FredM67/PVRouter-KiCad/Readme.md

Français | **[English](Readme.en.md)**

# PVRouter-KiCad

Fichiers de conception KiCad pour le **Mk2 PV Router** — un système open-source de routage solaire photovoltaïque universel (monophasé, triphasé avec ou sans neutre, biphasé).

Inspiré par [www.mk2pvrouter.co.uk](https://www.mk2pvrouter.co.uk), ce projet fournit les schémas et circuits imprimés nécessaires pour construire un routeur PV capable de dévier l’excédent de production solaire vers des charges résistives (chauffe-eau, radiateurs, etc.).

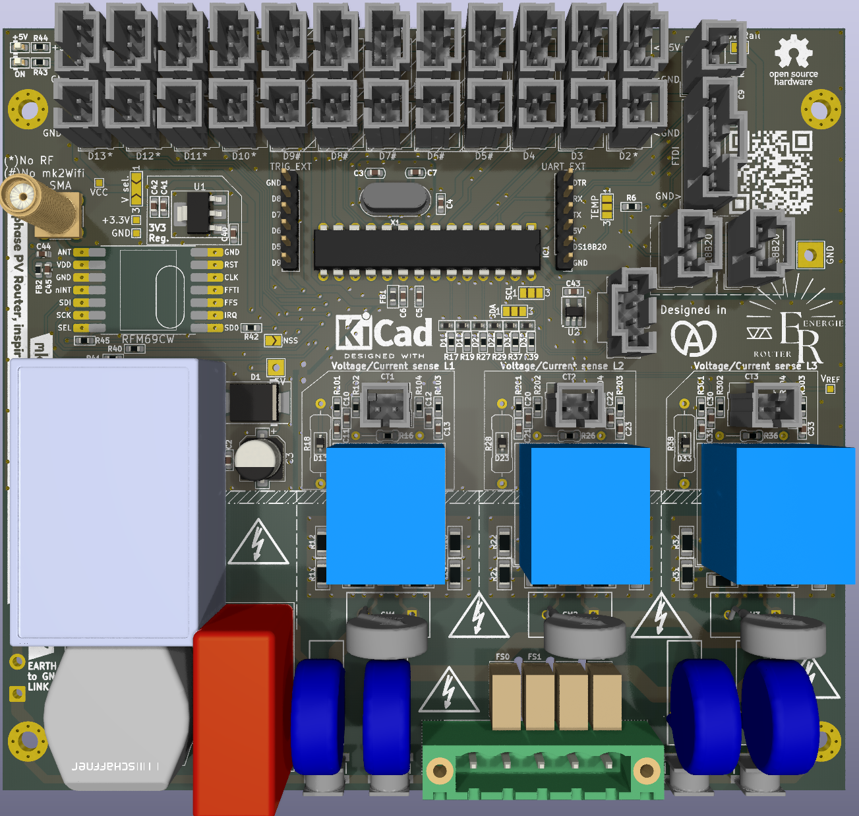
[picture p1: mainboard/assets/3phaseDiverter-front.png]
Carte principale


## Structure du dépôt

| Répertoire | Description | État |
|---|---|---|
| [`mainboard/`](mainboard/) | Carte principale universelle (3phaseDiverter) — rév. 6.0 | Conception active |
| [`output_stage/`](output_stage/) | Étage de puissance de sortie (carte séparée) | Conception active |
| [`expansion_boards/mk2Wifi-C3/`](expansion_boards/mk2Wifi-C3/) | Module d’extension WiFi/BLE (ESP32-C3) | Conception active |
| [`expansion_boards/mk2Wifi-C6/`](expansion_boards/mk2Wifi-C6/) | Module d’extension WiFi 6/BLE/Zigbee/Thread (ESP32-C6) | Conception active |
| [`1-phase/`](1-phase/) | Variante monophasée (schéma uniquement, pas de PCB) | Obsolète — encore en vente |
| [`3-phase/`](3-phase/) | Variante triphasée (ancienne version) | Obsolète — encore en vente |
| [`KiCad/`](KiCad/) | Bibliothèques partagées (symboles, empreintes, modèles 3D) | — |

## Carte principale

La carte principale est le cœur du projet. Universelle, elle prend en charge les configurations monophasée, triphasée (avec ou sans neutre) et biphasée (split-phase). Selon la configuration, jusqu’à 3 transformateurs de courant (CT) sont nécessaires. Elle intègre :

- Microcontrôleur ATmega328P
- Jusqu’à 3 capteurs de courant (transformateurs de courant)
- Jusqu’à 3 capteurs de tension (ZMPT101B)
- Module radio RFM69 (433 MHz)
- Alimentation intégrée à partir du secteur
- Protection contre les surtensions (GDT + fusibles)
- Connecteurs d’extension (TRIG_EXT, UART_EXT)

La carte est conçue pour être montée dans un boîtier Schneider Electric Thalassa.

## Modules d’extension

- **[mk2Wifi-C3](expansion_boards/mk2Wifi-C3/)** — Module WiFi/BLE basé sur l'ESP32-C3-MINI-1, avec connecteur USB-C, écran OLED optionnel et capteur de température DS18B20
- **[mk2Wifi-C6](expansion_boards/mk2Wifi-C6/)** — Module WiFi 6/BLE/Zigbee/Thread basé sur l'ESP32-C6-MINI-1, avec connecteur USB-C, écran OLED optionnel et capteur de température DS18B20

## Étage de puissance

L’**[étage de puissance](output_stage/)** est une carte séparée qui gère la commutation des charges résistives via des triacs ou des relais statiques (SSR).

## Outils requis

- [KiCad 9.0](https://www.kicad.org/) ou supérieur
- Les bibliothèques personnalisées sont incluses dans le répertoire `KiCad/` et référencées automatiquement via les fichiers `fp-lib-table` et `sym-lib-table`

## Liens

- Site de référence : [www.mk2pvrouter.co.uk](https://www.mk2pvrouter.co.uk)
- GitHub : [github.com/FredM67/PVRouter-KiCad](https://github.com/FredM67/PVRouter-KiCad)
