FredM67/PVRouter-KiCad/1-phase/Readme.md

Mk2PVRouter 1-phase

> **Obsolète** — ce design est remplacé par la [carte principale universelle](../mainboard/). Les cartes existantes restent en vente jusqu'à la validation complète de la nouvelle version.

> **Obsolete** — this design is superseded by the [universal mainboard](../mainboard/). Existing boards are still sold until the new version is fully tested.
