FredM67/PVRouter-KiCad/expansion_boards/mk2Wifi-C6/Readme.en.md

**[Français](Readme.md)** | English

# mk2Wifi-C6

WiFi/BLE expansion module for the Mk2 PV Router mainboard.

## Overview

The mk2Wifi-C6 board adds wireless connectivity to the Mk2 PV Router using an **ESP32-C6-MINI-1** module (RISC-V single-core, WiFi 6, Bluetooth LE 5, Zigbee, Thread). It plugs directly into the mainboard via the TRIG_EXT and UART_EXT pin headers and is powered by +5V from the mainboard, regulated locally to +3.3V.

Key features:
- WiFi 802.11 b/g/n/ax (2.4 GHz) and Bluetooth LE 5
- Zigbee and Thread (802.15.4)
- USB-C connector for initial firmware upload (subsequent updates via OTA)
- Optional OLED display via I2C (Molex SL connector)
- Five GPIO trigger/control outputs (D5--D9) to the mainboard
- Four additional GPIOs (GPIO19--GPIO22) on a 5-pin MISC header
- DS18B20 1-Wire temperature sensor passthrough
- UART serial link to the mainboard

## Board images

| Front (fully assembled) | Back |
|:-:|:-:|
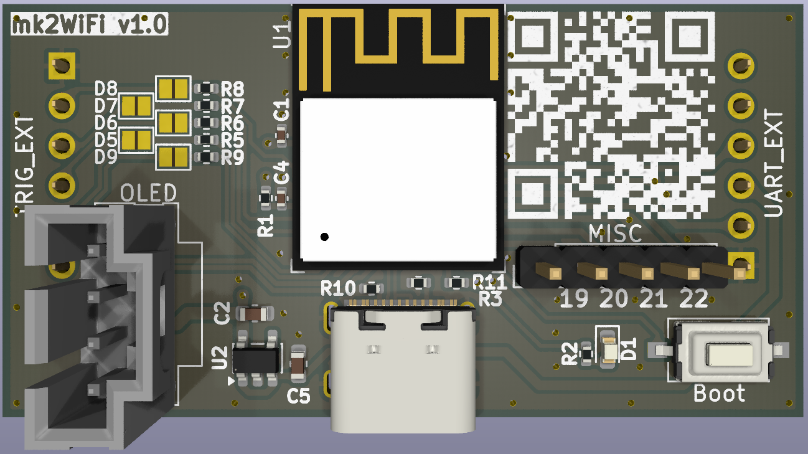
[picture p8: expansion_boards/mk2Wifi-C6/assets/mk2Wifi-C6-front.png]
Front
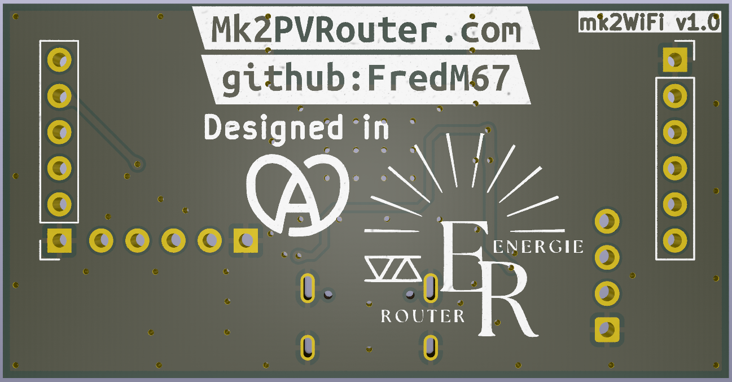
[picture p9: expansion_boards/mk2Wifi-C6/assets/mk2Wifi-C6-back.png]
Back
|  |  |

| SMD components only | Bare board layout |
|:-:|:-:|
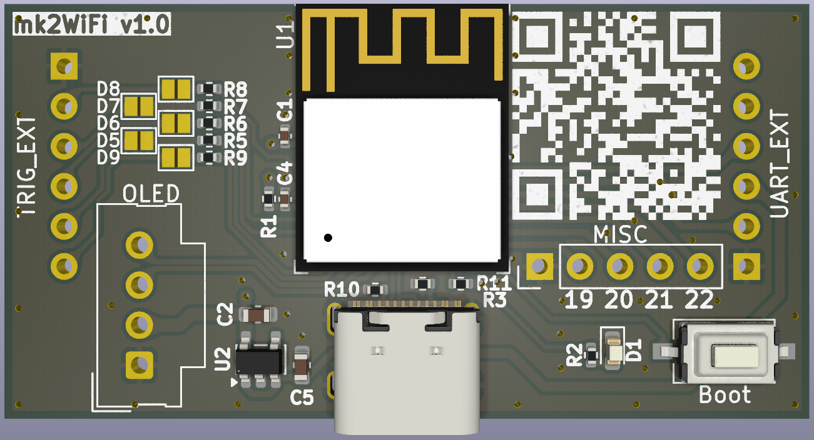
[picture p10: expansion_boards/mk2Wifi-C6/assets/mk2Wifi-C6-smd.png]
SMD
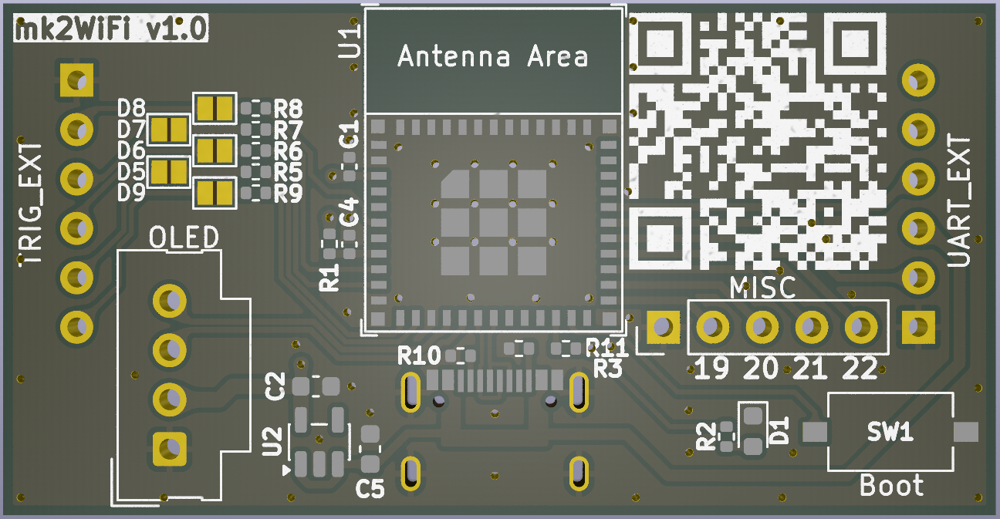
[picture p11: expansion_boards/mk2Wifi-C6/assets/mk2Wifi-C6-bare.png]
Bare
|  |  |

## Schematic

mk2Wifi-C6 schematic

## Design files

| File | Description |
|---|---|
| `mk2Wifi-C6.kicad_pro` | KiCad 9 project file |
| `mk2Wifi-C6.kicad_sch` | Schematic |
| `mk2Wifi-C6.kicad_pcb` | PCB layout |
| `mk2Wifi-C6.kicad_dru` | Design rules |
| `mk2Wifi-C6.kicad_sym` | Board-local custom symbol library |
| `sym-lib-table` | Symbol library table |
| `fp-lib-table` | Footprint library table |

## Bill of Materials

| Ref | Value | Package | Description |
|-----|---|---|---|
| U1 | ESP32-C6-MINI-1 | ESP32-C6-MINI-1 | MCU module with WiFi 6/BLE/Zigbee/Thread |
| U2 | AP2112K-3.3 | SOT-23-5 | 3.3V LDO regulator (600mA) |
| UART_EXT | UART_EXT | PinSocket 1x06 2.54mm | UART + DS18B20 header |
| TRIG_EXT | TRIG_EXT | PinSocket 1x06 2.54mm | Trigger/GPIO header |
| USB-C | USB_C_Receptacle | CSP-USC16-TR | USB Type-C receptacle |
| OLED | OLED | Molex SL 1x04 2.54mm | OLED display connector |
| MISC | MISC | PinHeader 1x05 2.54mm | Additional GPIO header (GPIO19--22) |
| D1 | LED | 0603 | Power indicator |
| SW1 | SW_Push | CK PTS636S | Boot mode button (GPIO9) |
| R1 | 10K | 0402 | EN pull-up |
| R2 | 1K | 0402 | LED current limiter |
| R3 | 10K | 0402 | GPIO8 pull-up (strapping) |
| R5 | 1K | 0402 | D5 series protection (GPIO0) |
| R6 | 1K | 0402 | D6 series protection (GPIO5) |
| R7 | 1K | 0402 | D7 series protection (GPIO4) |
| R8 | 1K | 0402 | D8 series protection (GPIO3) |
| R9 | 1K | 0402 | D9 series protection (GPIO1) |
| R10 | 5K1 | 0402 | USB CC1 pull-down |
| R11 | 5K1 | 0402 | USB CC2 pull-down |
| C1 | 100nF | 0402 | +3.3V bypass |
| C2 | 4.7uF | 0603 | Regulator output capacitor |
| C4 | 100nF | 0402 | +3.3V bypass (EN/OLED) |
| C5 | 4.7uF | 0603 | Regulator input capacitor |

## Connector pinouts

### UART_EXT (1x6 pin socket)

| Pin | Signal |
|-----|---|
| 1 | GND |
| 2 | DS18B20 |
| 3 | +5V |
| 4 | UART_RX |
| 5 | UART_TX |
| 6 | NC |

Signal names (UART_TX, UART_RX) are from the **mainboard's** perspective: UART_TX carries data transmitted by the mainboard, received by the ESP32-C6 on U0RXD.

### TRIG_EXT (1x6 pin socket)

| Pin | Signal |
|-----|---|
| 1 | GND |
| 2 | D8 |
| 3 | D7 |
| 4 | D6 |
| 5 | D5 |
| 6 | D9 |

### OLED (1x4 Molex SL)

| Pin | Signal |
|-----|---|
| 1 | GND |
| 2 | VCC (+3.3V) |
| 3 | SCL |
| 4 | SDA |

### MISC (1x5 pin header)

| Pin | Signal |
|-----|---|
| 1 | GND |
| 2 | GPIO19 |
| 3 | GPIO20 |
| 4 | GPIO21 |
| 5 | GPIO22 |

These 4 GPIOs are directly connected to the ESP32-C6 (pins 25--28) with no series resistors. They can be used for additional sensors, I/O, or communication interfaces.

## ESP32-C6 GPIO mapping

### Connector GPIOs

| GPIO | Pin | Function | Notes |
|---|-----|---|---|
| GPIO0 | 12 | D5 (trigger output) | 1K series resistor (R5) to TRIG_EXT pin 5 |
| GPIO1 | 13 | D9 (trigger output) | 1K series resistor (R9) to TRIG_EXT pin 6 |
| GPIO3 | 6 | D8 (trigger output) | 1K series resistor (R8) to TRIG_EXT pin 2 |
| GPIO4 | 9 | D7 (trigger output) | 1K series resistor (R7) to TRIG_EXT pin 3 |
| GPIO5 | 10 | D6 (trigger output) | 1K series resistor (R6) to TRIG_EXT pin 4 |
| GPIO6 | 15 | SDA (I2C data) | Direct to OLED pin 4 |
| GPIO7 | 16 | SCL (I2C clock) | Direct to OLED pin 3 |
| GPIO12 | 17 | USB D- | To USB-C |
| GPIO13 | 18 | USB D+ | To USB-C |
| GPIO16/U0TXD | 31 | UART serial | Net UART_RX — UART_EXT pin 4 (mainboard receives from ESP) |
| GPIO17/U0RXD | 30 | UART serial | Net UART_TX — UART_EXT pin 5 (mainboard transmits to ESP) |
| GPIO19 | 25 | General purpose I/O | Direct to MISC pin 2 |
| GPIO20 | 26 | General purpose I/O | Direct to MISC pin 3 |
| GPIO21 | 27 | General purpose I/O | Direct to MISC pin 4 |
| GPIO22 | 28 | General purpose I/O | Direct to MISC pin 5 |
| GPIO23 | 29 | DS18B20 (1-Wire) | Direct to UART_EXT pin 2 |

### Strapping pins

The ESP32-C6 has 5 strapping pins sampled at reset to configure boot behavior:

| GPIO | Pin | Function | Default | Board handling |
|---|-----|---|---|---|
| GPIO8 | 22 | Boot mode + ROM print | Floating | R3 (10K) pull-up to +3.3V |
| GPIO9 | 23 | Boot mode | Weak pull-up (1) | SW1 pulls to GND for download mode |
| GPIO15 | 20 | JTAG source | Floating | Unconnected (ignored with default eFuses) |
| MTMS/GPIO4 | 9 | SDIO clock edge | Floating | R7 (1K) to D7/TRIG_EXT (SDIO not used) |
| MTDI/GPIO5 | 10 | SDIO clock edge | Floating | R6 (1K) to D6/TRIG_EXT (SDIO not used) |

**Boot mode** (GPIO8/GPIO9): GPIO9=1 (default) selects normal SPI flash boot. Hold SW1 during reset to pull GPIO9 low and enter download mode (USB-Serial-JTAG / UART / SDIO).

**GPIO15**: Controls JTAG signal source, but only when `EFUSE_JTAG_SEL_ENABLE`=1. With default eFuse values (all 0), GPIO15 is ignored and JTAG defaults to USB Serial/JTAG controller. No external pull resistor needed.

**MTMS/MTDI**: Control SDIO sampling/driving clock edge. Since SDIO is not used on this board, the floating default through 1K series resistors has no effect on operation.

## Power supply

In normal operation, **+5V** is supplied from the mainboard through the UART_EXT header (pin 3). The AP2112K-3.3 LDO (U2) regulates this to +3.3V for the ESP32-C6 and OLED display, with a maximum output of 600mA.

Decoupling:
- C5 (4.7uF) on the +5V regulator input
- C2 (4.7uF) on the +3.3V regulator output
- C1, C4 (100nF each) local bypass on +3.3V rails

The USB-C connector can also supply +5V during initial programming when the board is not connected to the mainboard. R10 and R11 (5K1 each) on CC1/CC2 configure the USB-C port as a UFP (sink) to request 5V from the host.

> **WARNING:** Do not connect USB-C while the mk2Wifi board is plugged into the mainboard. The two +5V supplies (USB and mainboard) are not isolated and connecting both simultaneously may damage the board or the USB host.

D1 is a power indicator LED, always on when +3.3V is present (current limited by R2).

## Mainboard integration

The mk2Wifi board plugs into the mainboard's **TRIG_EXT** and **UART_EXT** pin headers:

- mk2Wifi uses **pin sockets** (female); the mainboard uses **pin headers** (male)
- +5V power is supplied from the mainboard through UART_EXT pin 3
- UART (TX/RX) provides serial communication with the mainboard ATmega328P
- DS18B20 signal passes through for 1-Wire temperature sensing
- GPIO signals D5--D9 provide trigger/control outputs
- The I2C bus (SCL/SDA) is **local to the mk2Wifi board only** -- it connects the ESP32-C6 to the OLED display and is not routed to the mainboard

## Programming

1. **Initial firmware upload**: Unplug the board from the mainboard, then connect a USB-C cable. The ESP32-C6 has a built-in USB-serial/JTAG controller -- no external programmer is needed.
2. **Enter download mode**: Hold SW1 (GPIO9 low) during power-up, then release.
3. **Subsequent updates**: Use OTA (Over-The-Air) firmware updates via WiFi. The USB-C connection is only needed for the first flash.
