FredM67/PVRouter-KiCad/1-phase/PCB_Carte mère de base 4 couches rev2 (Prise display retourné)_2023-05-05.dxf

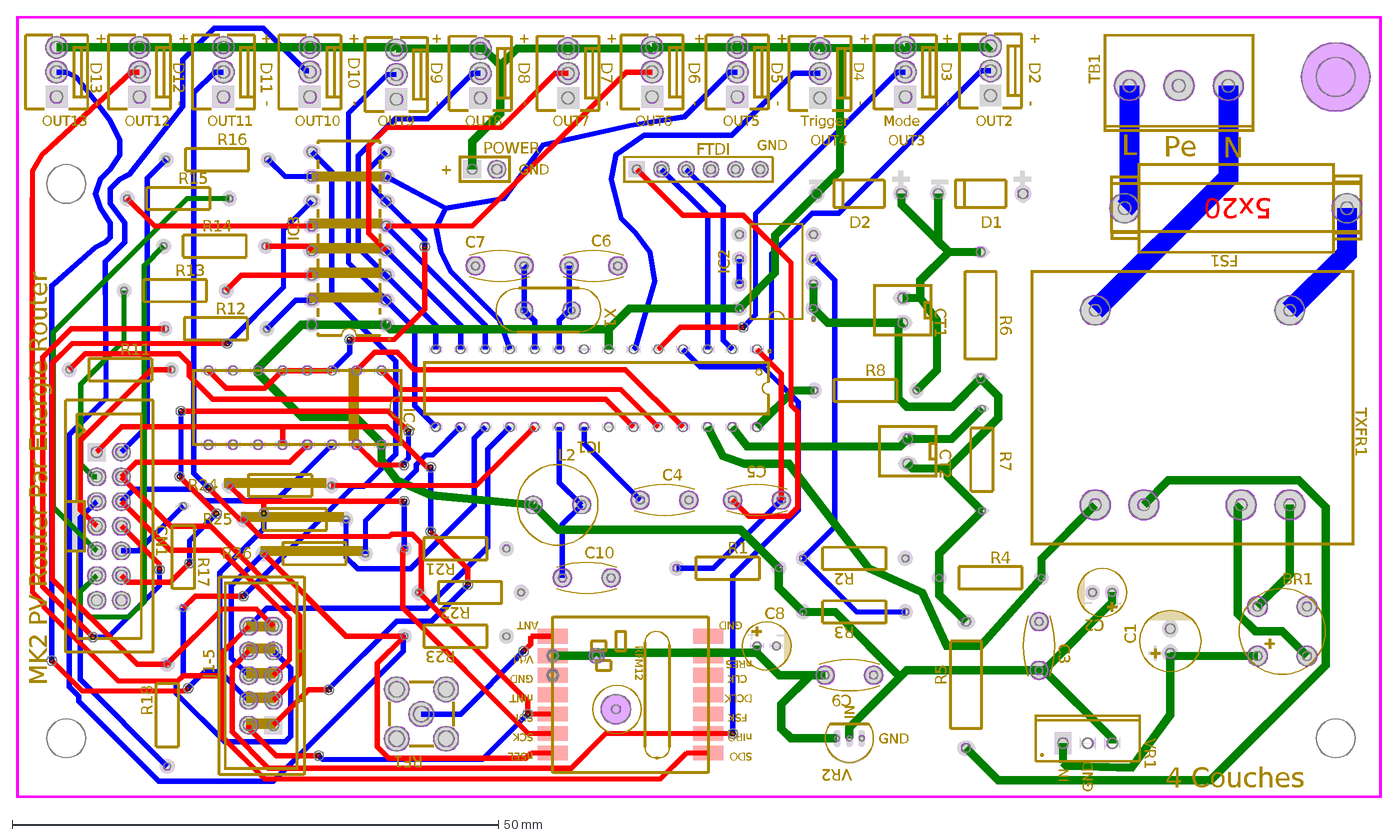
[picture p16: CAD file, 2023-05-05]
1-phase/PCB_Carte mère de base 4 couches rev2 (Prise display retourné)_2023-05-05.dxf
L
N
Pe
MK2 PV Router Par Energie Router
GND
+
OUT13
Trigger
OUT4
Mode
OUT3
OUT2
OUT5
OUT6
OUT7
OUT8
OUT9
OUT10
OUT11
OUT12
-
IN
4 Couches
D2
D3
D4
D5
D6
D7
D8
D9
D10
D11
D12
D13
L2
RF1
BR1
C1
C2
C8
C3
C4
C5
C6
C7
C9
C10
CN1
CT1
CT2
D1
FS1
5x20
FTDI
IC1
IC2
IC3
IC4
J1-5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
