FredM67/PVRouter-KiCad/KiCad/3dmodels/CopperStrap_SLINE.step

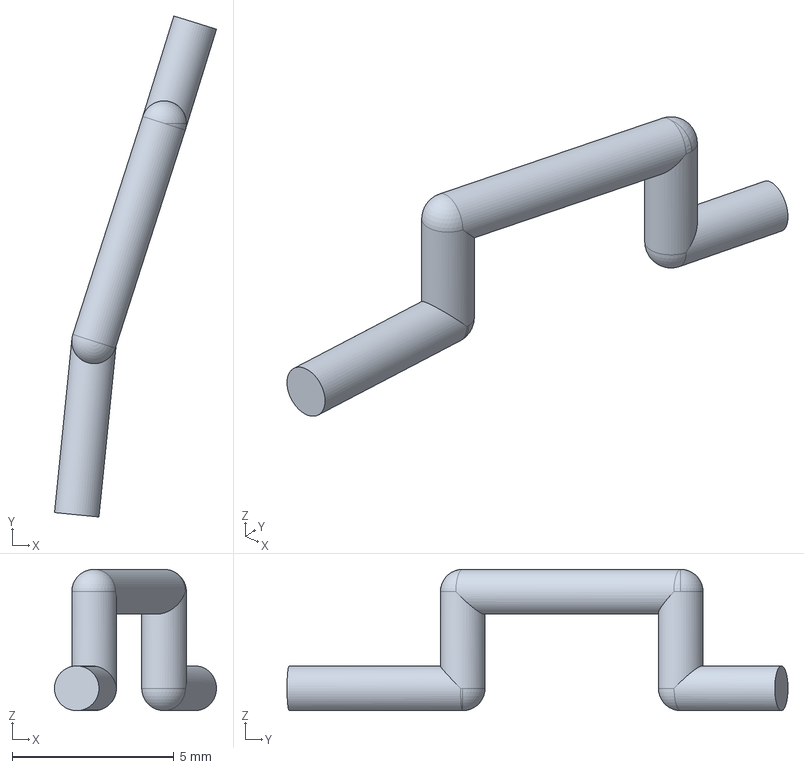
[picture p17: CAD file, 2026-03-25]
KiCad/3dmodels/CopperStrap_SLINE.step
5.00 x 15.5 x 4.36 mm
