FredM67/PVRouter-KiCad/KiCad/3dmodels/CopperStrap_LINE.step

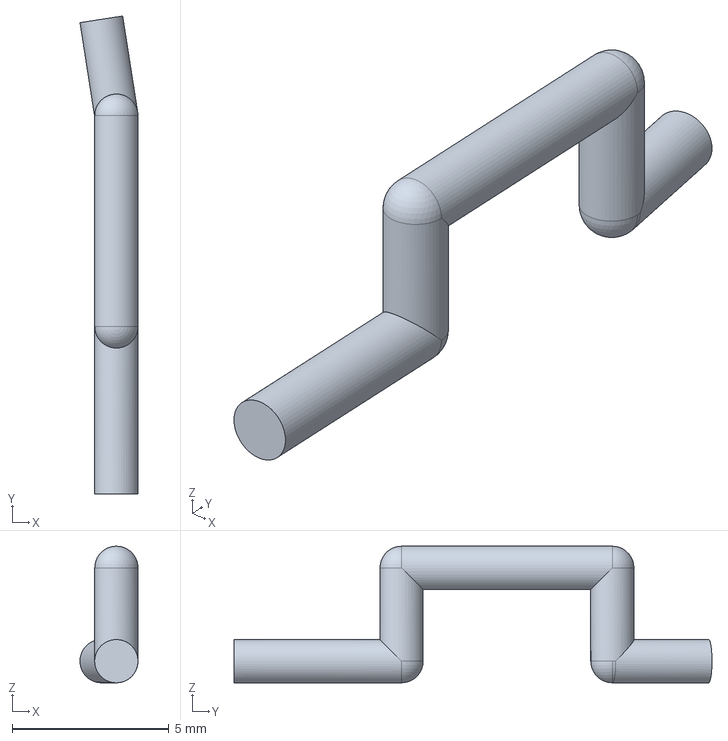
[picture p18: CAD file, 2026-03-25]
KiCad/3dmodels/CopperStrap_LINE.step
1.85 x 15.3 x 4.36 mm
