FredM67/PVRouter-KiCad/KiCad/3dmodels/TMF_05105.stp

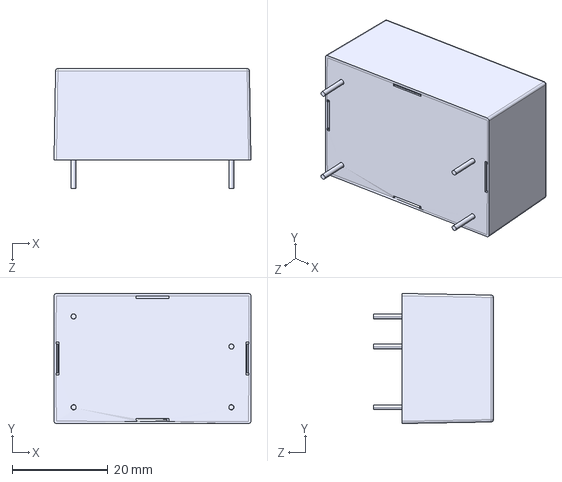
[picture p19: CAD file, 2026-02-27]
KiCad/3dmodels/TMF_05105.stp
41.2 x 27.2 x 25.1 mm
