FredM67/PVRouter-KiCad/KiCad/3dmodels/ESP32-C3-MINI-1-N4--3DModel-STEP-418109.STEP

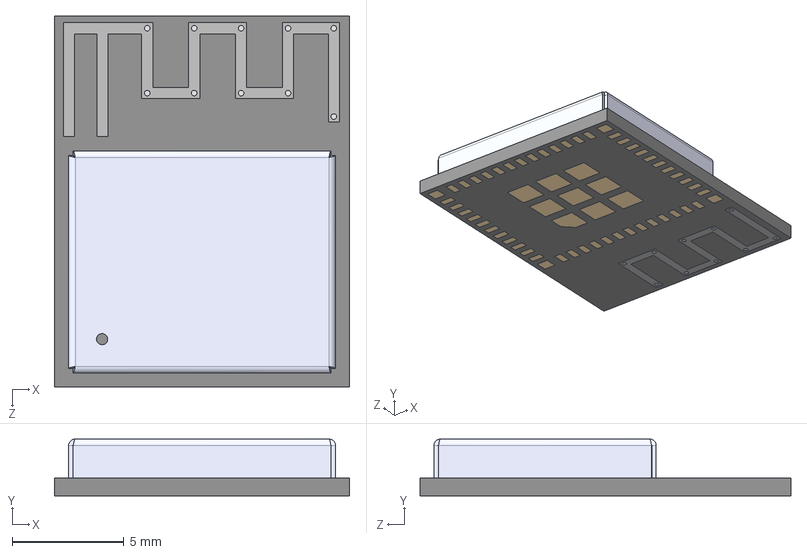
[picture p20: CAD file, 2026-02-16]
KiCad/3dmodels/ESP32-C3-MINI-1-N4--3DModel-STEP-418109.STEP
13.2 x 2.55 x 16.6 mm
