FredM67/PVRouter-KiCad/KiCad/3dmodels/MOV-14D471K.STEP

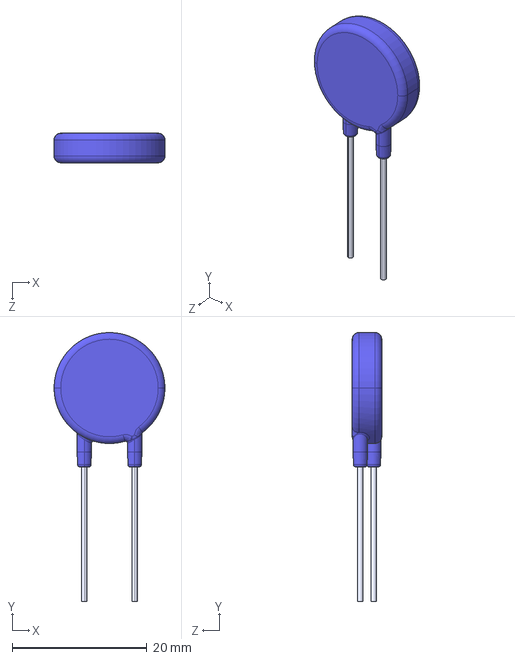
[picture p21: CAD file, 2026-01-05]
KiCad/3dmodels/MOV-14D471K.STEP
16.5 x 40.0 x 4.40 mm
