FredM67/PVRouter-KiCad/KiCad/3dmodels/AP2112R5A-3.3TRG1.stp

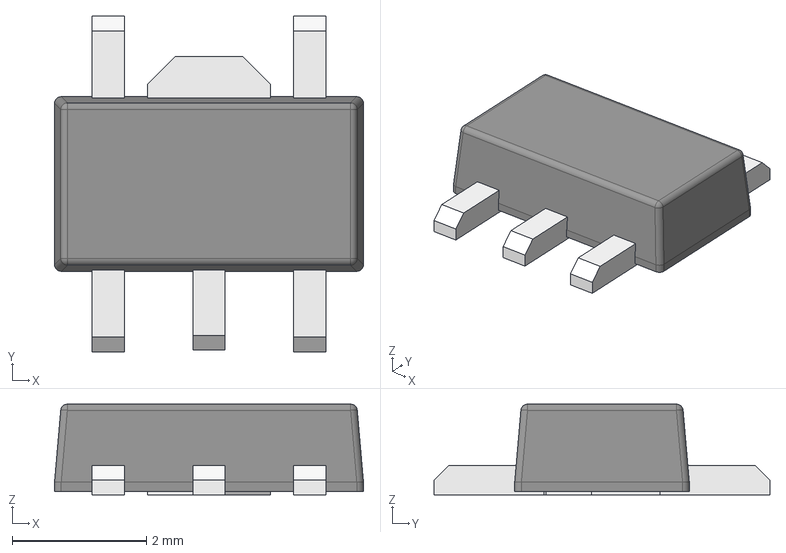
[picture p22: CAD file, 2025-09-14]
KiCad/3dmodels/AP2112R5A-3.3TRG1.stp
4.60 x 5.00 x 1.35 mm
