FredM67/PVRouter-KiCad/KiCad/3dmodels/RAC05E-05SKT.stp

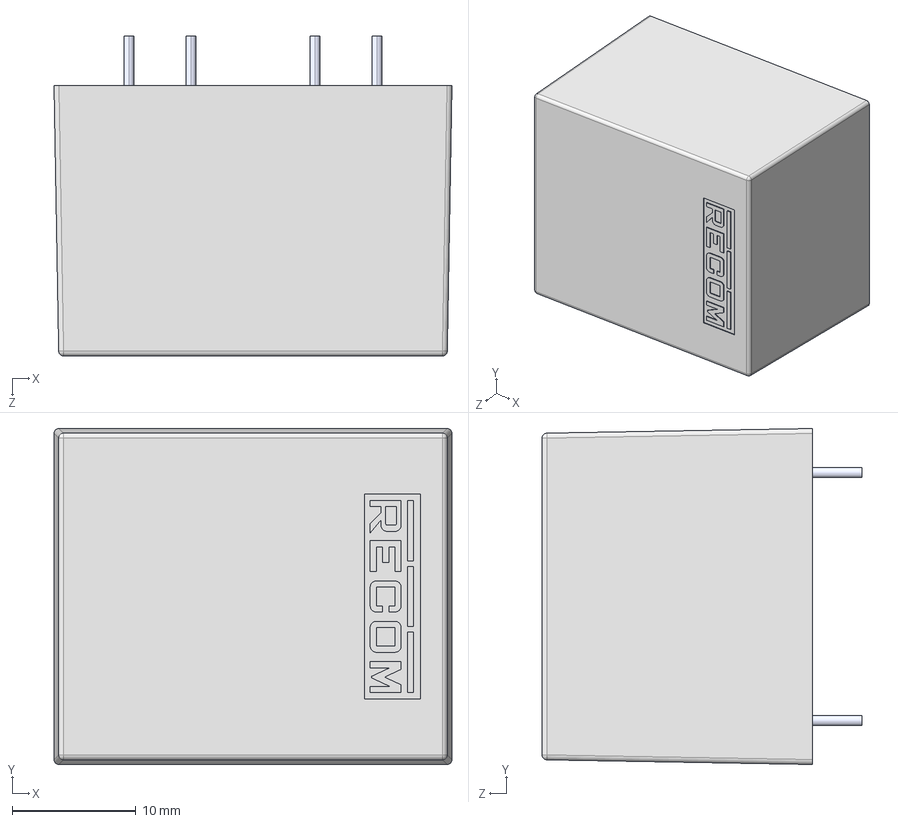
[picture p23: CAD file, 2025-05-19]
KiCad/3dmodels/RAC05E-05SKT.stp
32.1 x 27.1 x 25.8 mm
