FredM67/PVRouter-KiCad/KiCad/3dmodels/IsoM3-300-B-L2.stp

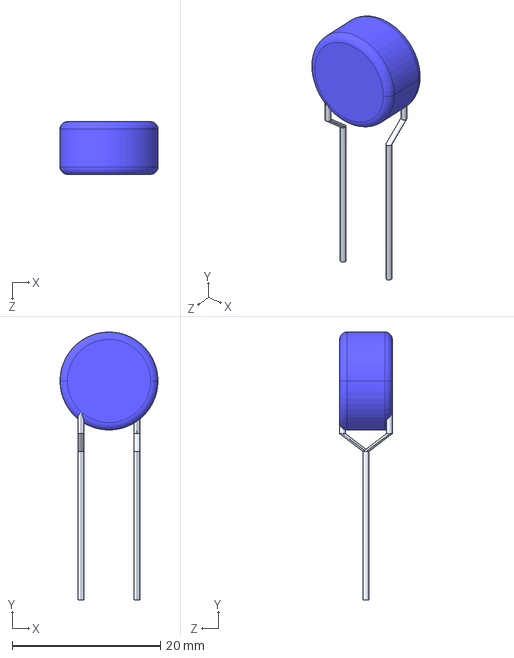
[picture p24: CAD file, 2024-05-30]
KiCad/3dmodels/IsoM3-300-B-L2.stp
13.2 x 36.1 x 7.10 mm
