FredM67/PVRouter-KiCad/KiCad/3dmodels/MOV14D-Kinked Leads (Outward).stp

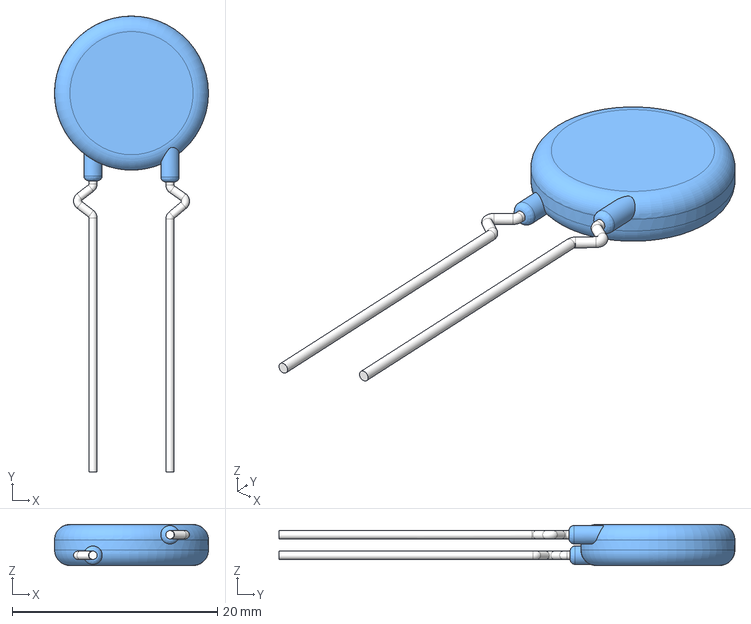
[picture p25: CAD file, 2024-05-30]
KiCad/3dmodels/MOV14D-Kinked Leads (Outward).stp
15.0 x 44.4 x 4.00 mm
