FredM67/PVRouter-KiCad/KiCad/3dmodels/IsoM3-300-B-L5.stp

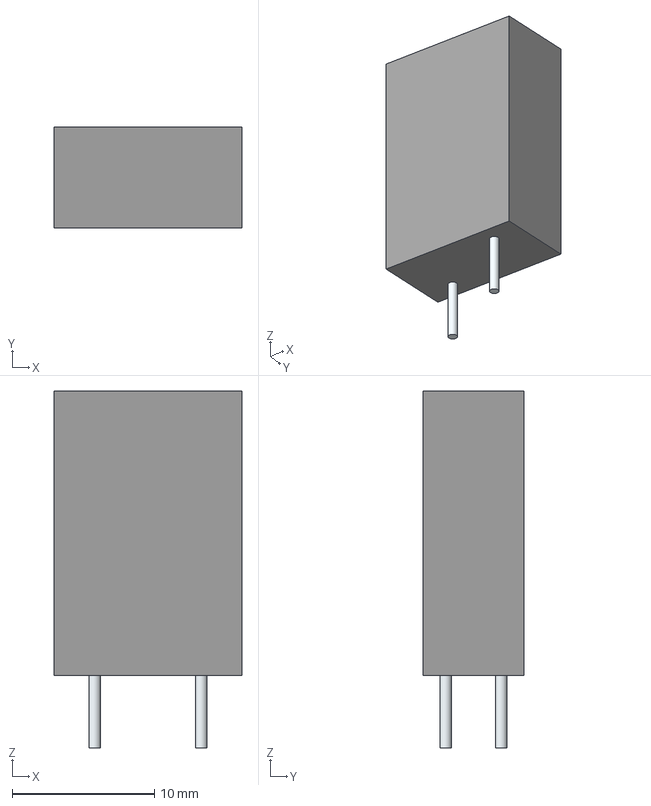
[picture p26: CAD file, 2024-05-30]
KiCad/3dmodels/IsoM3-300-B-L5.stp
13.2 x 7.10 x 25.1 mm
Leads
