FredM67/PVRouter-KiCad/KiCad/3dmodels/2093-xxx-sm.stp

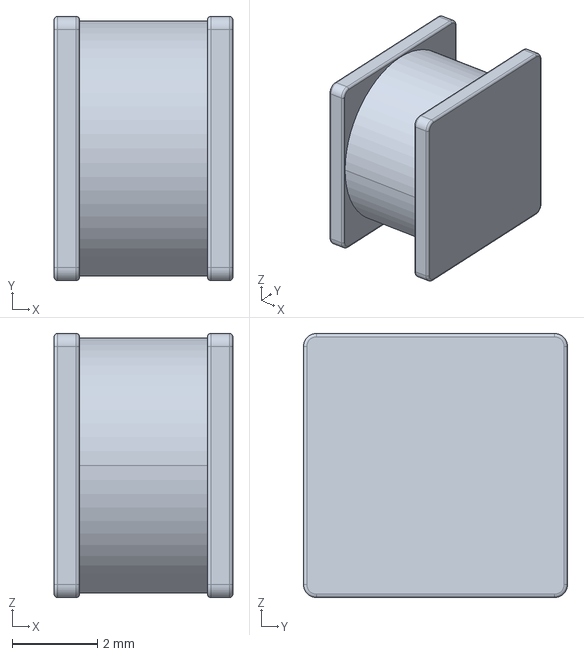
[picture p27: CAD file, 2024-05-24]
KiCad/3dmodels/2093-xxx-sm.stp
4.20 x 6.20 x 6.20 mm
