FredM67/PVRouter-KiCad/KiCad/3dmodels/GDT28H.STP

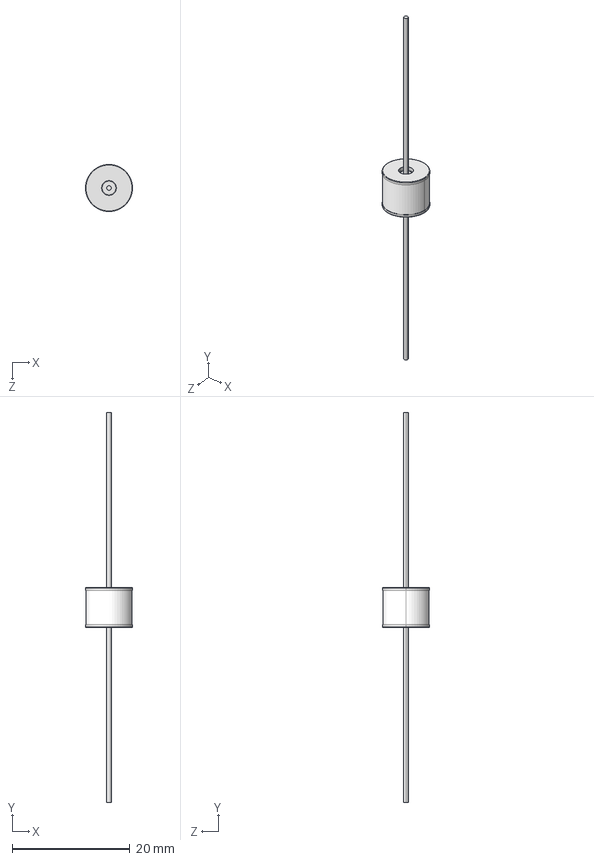
[picture p28: CAD file, 2024-05-24]
KiCad/3dmodels/GDT28H.STP
8.00 x 66.3 x 8.00 mm
