FredM67/PVRouter-KiCad/KiCad/3dmodels/AP2112R5-3_3TRG1_DIO.step

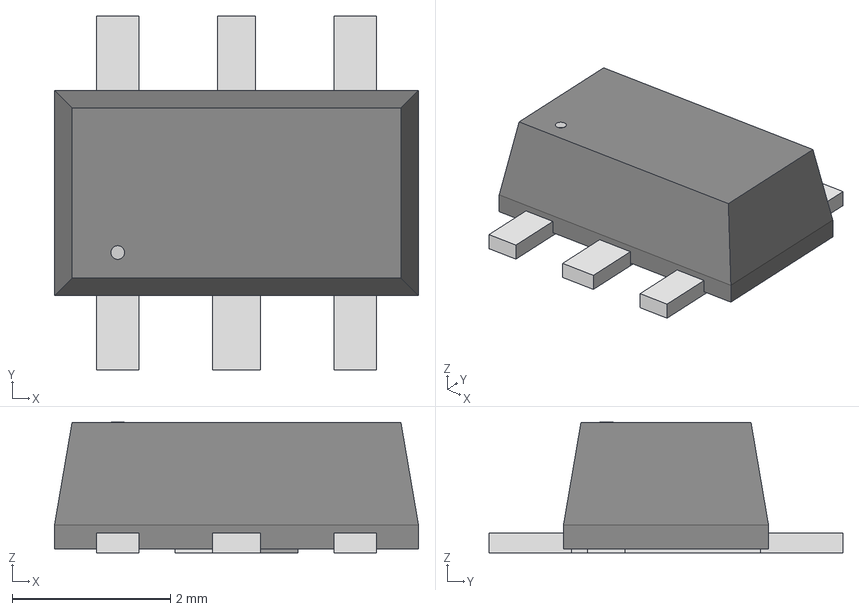
[picture p29: CAD file, 2024-05-04]
KiCad/3dmodels/AP2112R5-3_3TRG1_DIO.step
4.60 x 4.47 x 1.65 mm
