FredM67/PVRouter-KiCad/KiCad/3dmodels/LD10-23B05R2.step

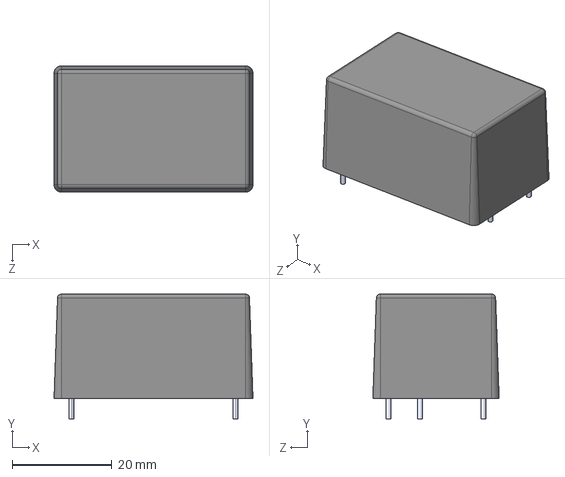
[picture p30: CAD file, 2024-05-04]
KiCad/3dmodels/LD10-23B05R2.step
40.0 x 25.1 x 25.4 mm
