FredM67/PVRouter-KiCad/KiCad/3dmodels/LD05-23B05R2.step

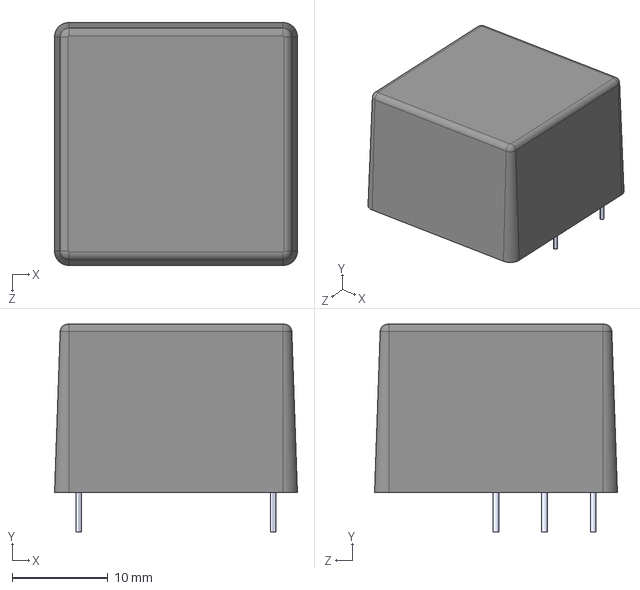
[picture p31: CAD file, 2024-05-04]
KiCad/3dmodels/LD05-23B05R2.step
25.4 x 21.7 x 25.4 mm
