FredM67/PVRouter-KiCad/KiCad/3dmodels/RN114-x-02.stp

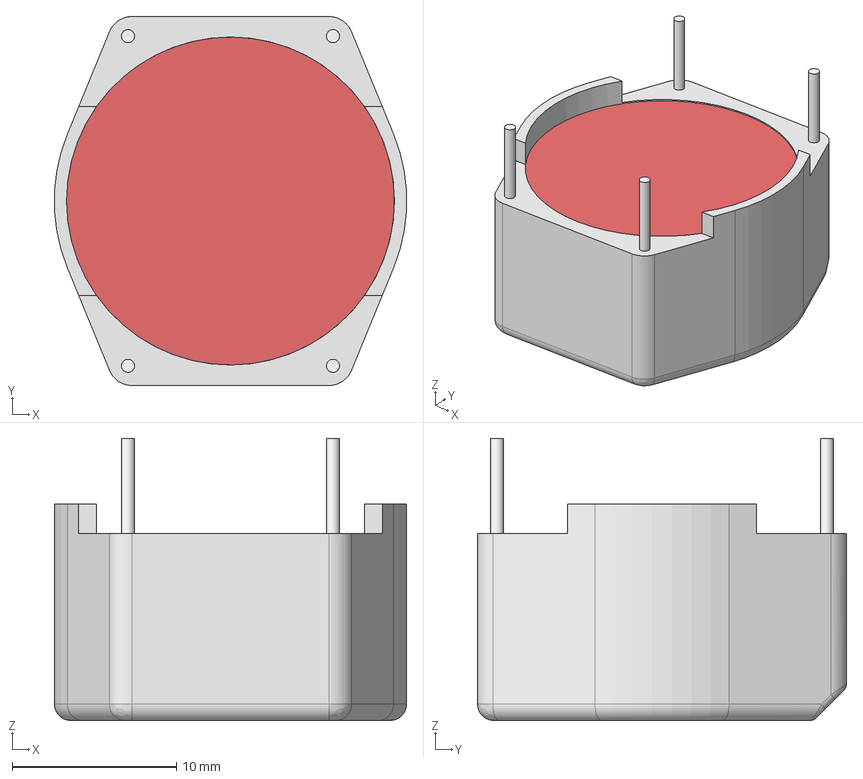
[picture p32: CAD file, 2024-05-04]
KiCad/3dmodels/RN114-x-02.stp
21.5 x 22.5 x 17.2 mm
