FredM67/PVRouter-KiCad/KiCad/3dmodels/AP2112K-3.3TRG1.step

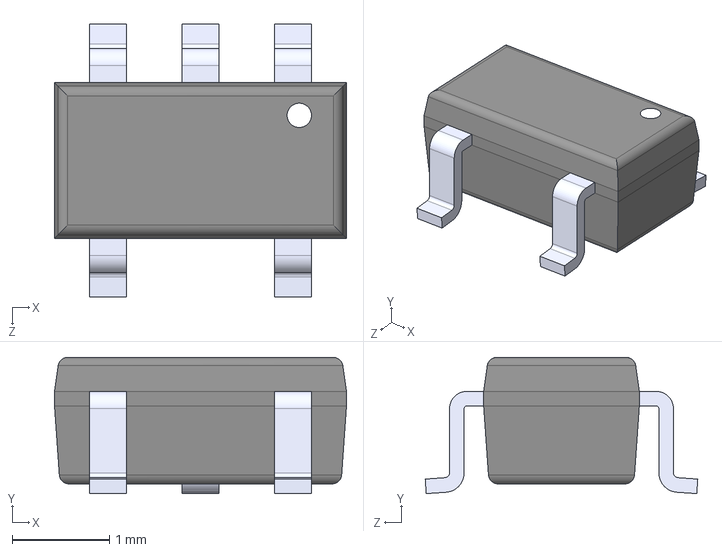
[picture p33: CAD file, 2024-05-04]
KiCad/3dmodels/AP2112K-3.3TRG1.step
3.00 x 1.40 x 2.80 mm
