FredM67/PVRouter-KiCad/KiCad/3dmodels/ZMPT101B.step

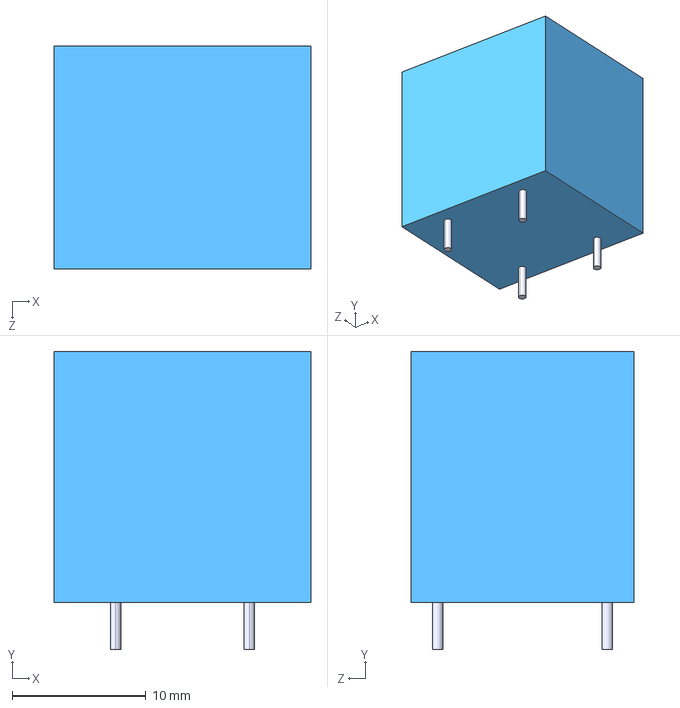
[picture p34: CAD file, 2024-05-04]
KiCad/3dmodels/ZMPT101B.step
19.2 x 22.3 x 16.7 mm
