FredM67/PVRouter-KiCad/KiCad/3dmodels/FUS_MULTICOMP_MCMSF_MTC.step

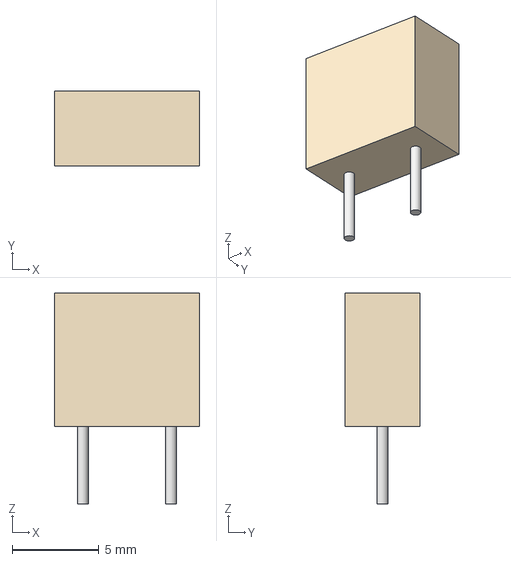
[picture p35: CAD file, 2024-05-04]
KiCad/3dmodels/FUS_MULTICOMP_MCMSF_MTC.step
8.36 x 4.29 x 12.1 mm
