FredM67/PVRouter-KiCad/(list of files, cad)

Other CAD files:
KiCad/3dmodels/mov-14d471k.stp
