FredM67/PVRouter-KiCad/output_stage/assets/Output_stage-schematic.pdf

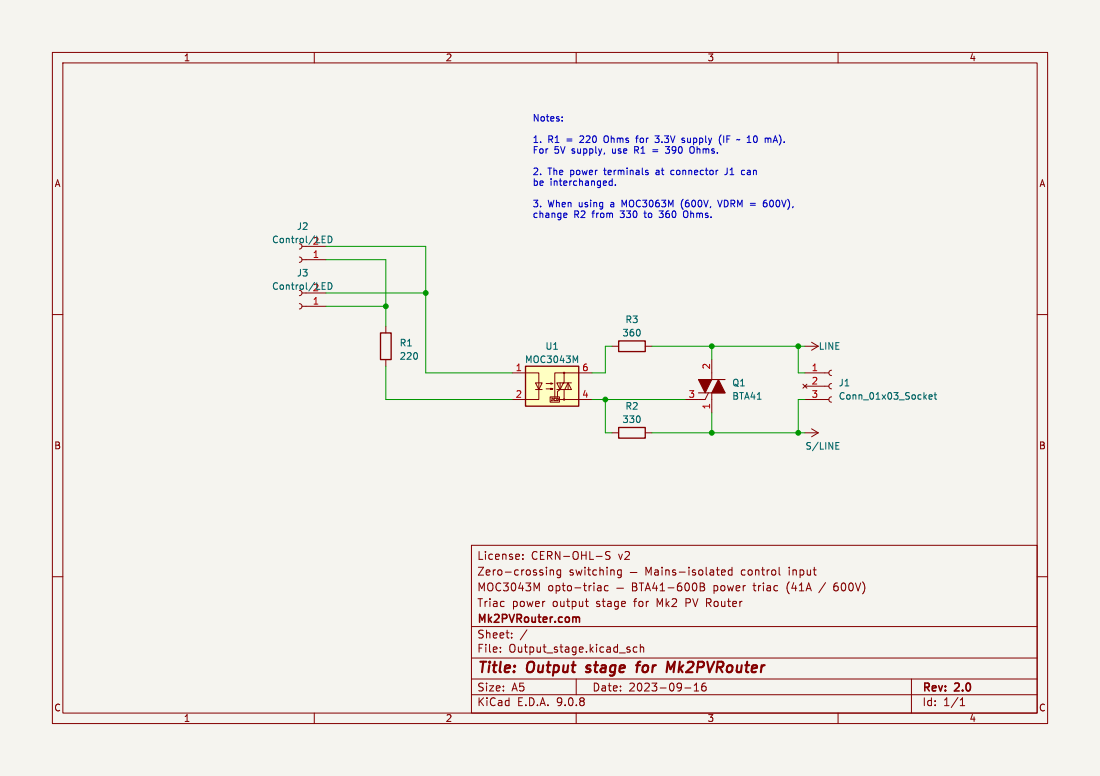
[picture p36: page 1]

2 1 Q1 BTA41 Notes: 1. R1 = 220 Ohms for 3.3V supply (IF ~ 10 mA). For 5V supply, use R1 = 390 Ohms. 2. The power terminals at connector J1 can

be interchanged. 3. When using a MOC3063M (600V, VDRM = 600V),

change R2 from 330 to 360 Ohms.

Triac power output stage for | opto-triac | þÿ BTA41-600B | Mk2 PV | Router MOC3043M power triac (41A / 600V)

Id: 1/1 Title: Output stage for Mk2PVRouter File: Output_stage.kicad_sch Sheet: / Mk2PVRouter.com
