FredM67/PVRouter-KiCad/mainboard/assets/3phaseDiverter-schematic.pdf

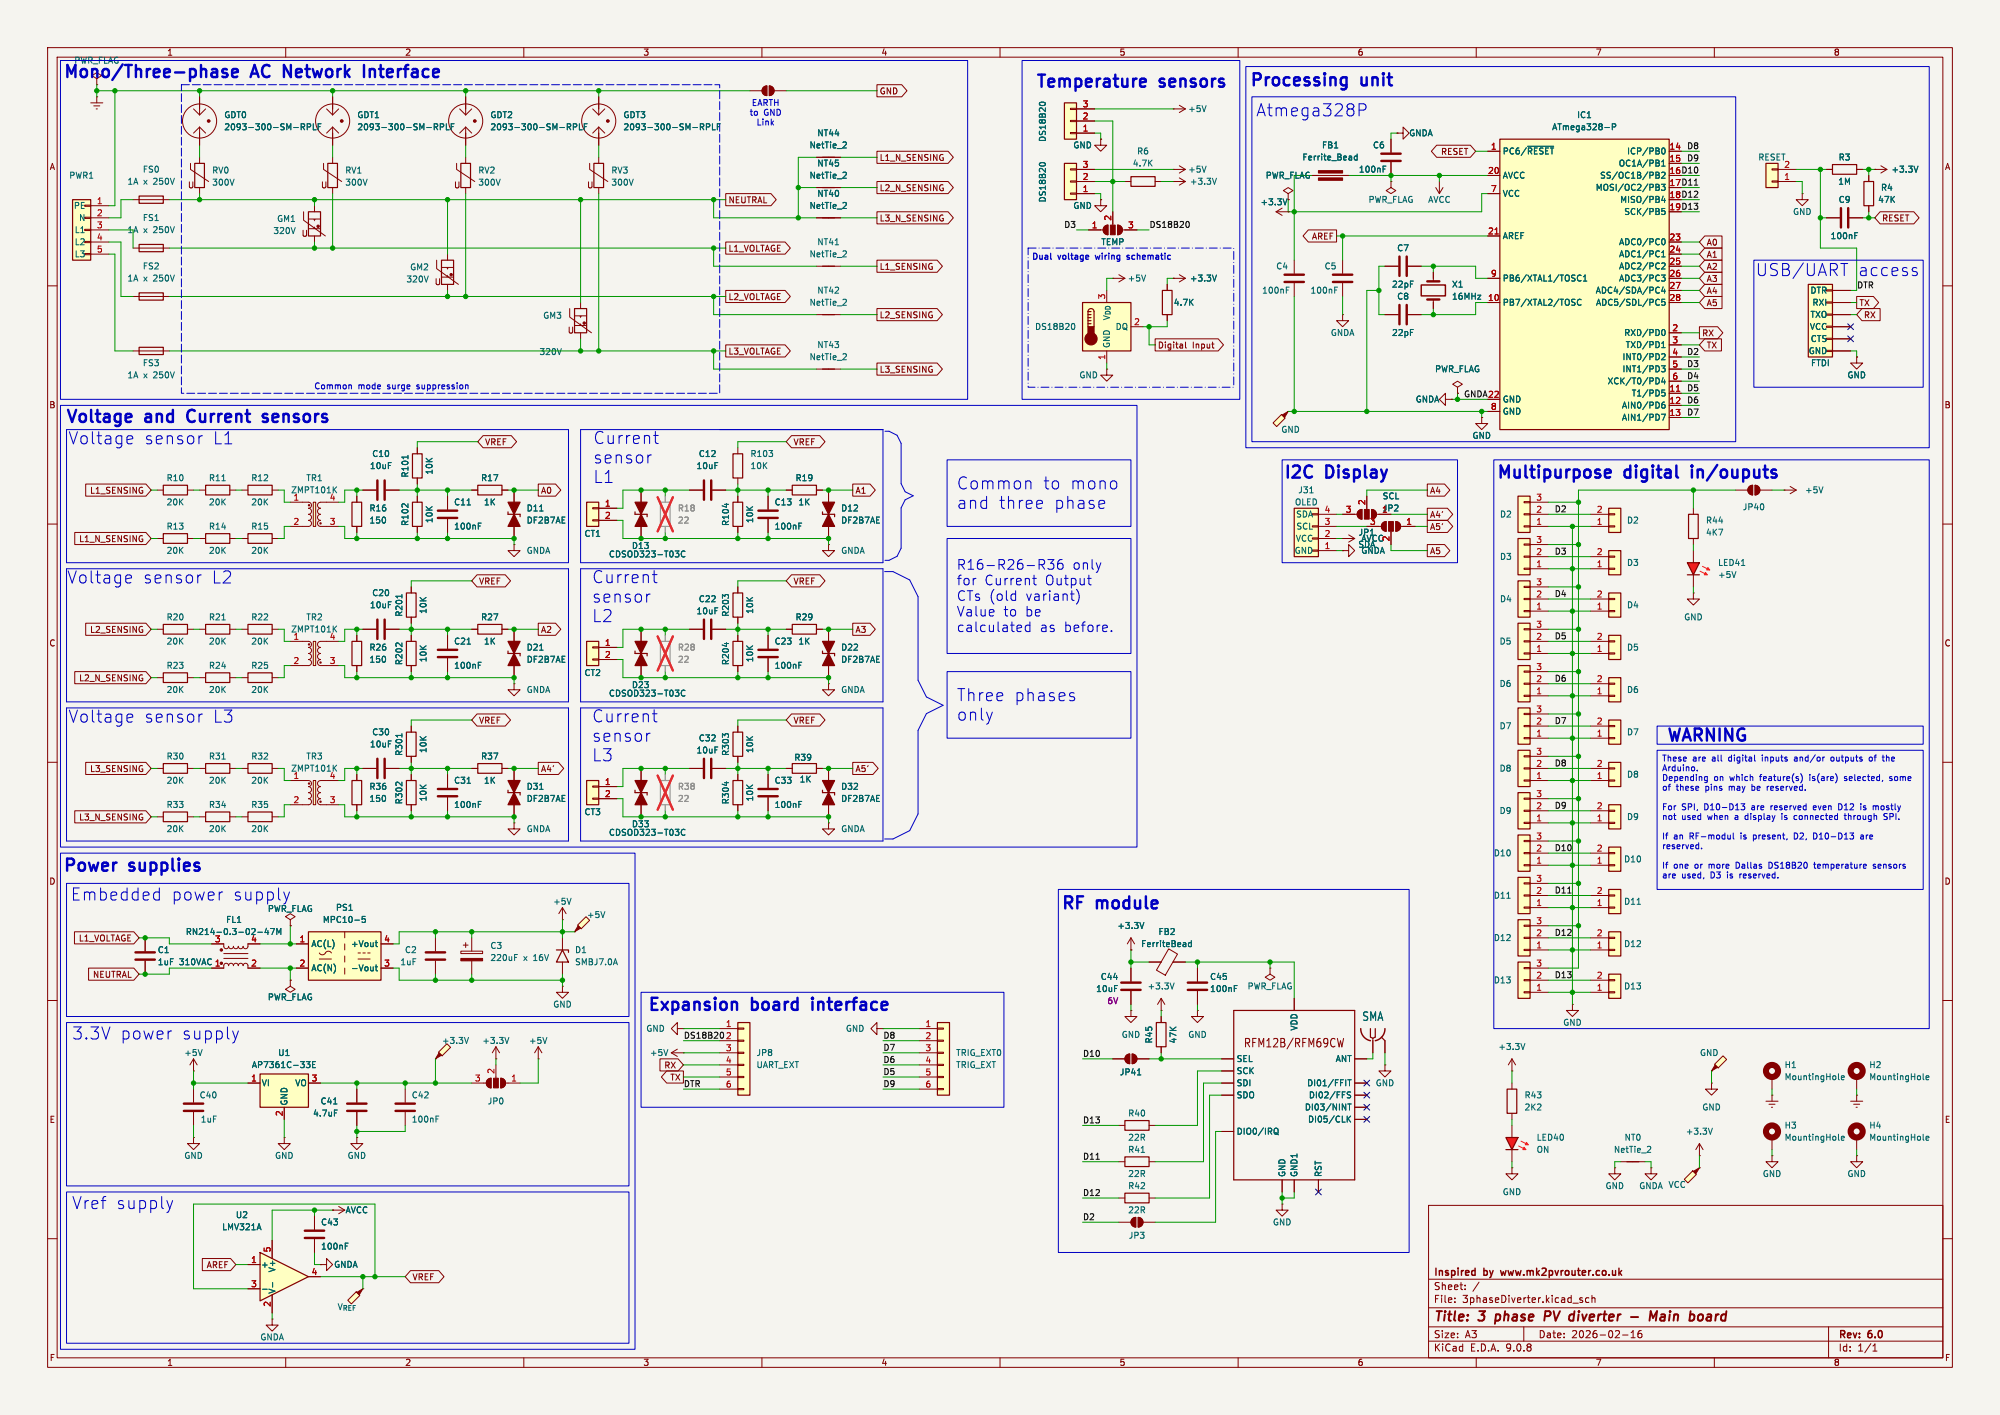
[picture p37: page 1]

Processing unit Dual voltage wiring schematic }

Common mode surge suppression

Voltage and Current sensors
Voltage sensor L1

File: 3phaseDiverter.kicad_sch Sheet: /
Id: 1/1 Title: 3 phase PV diverter - Main board
