FredM67/PVRouter-KiCad/expansion_boards/mk2Wifi-C3/assets/mk2Wifi-C3-schematic.pdf

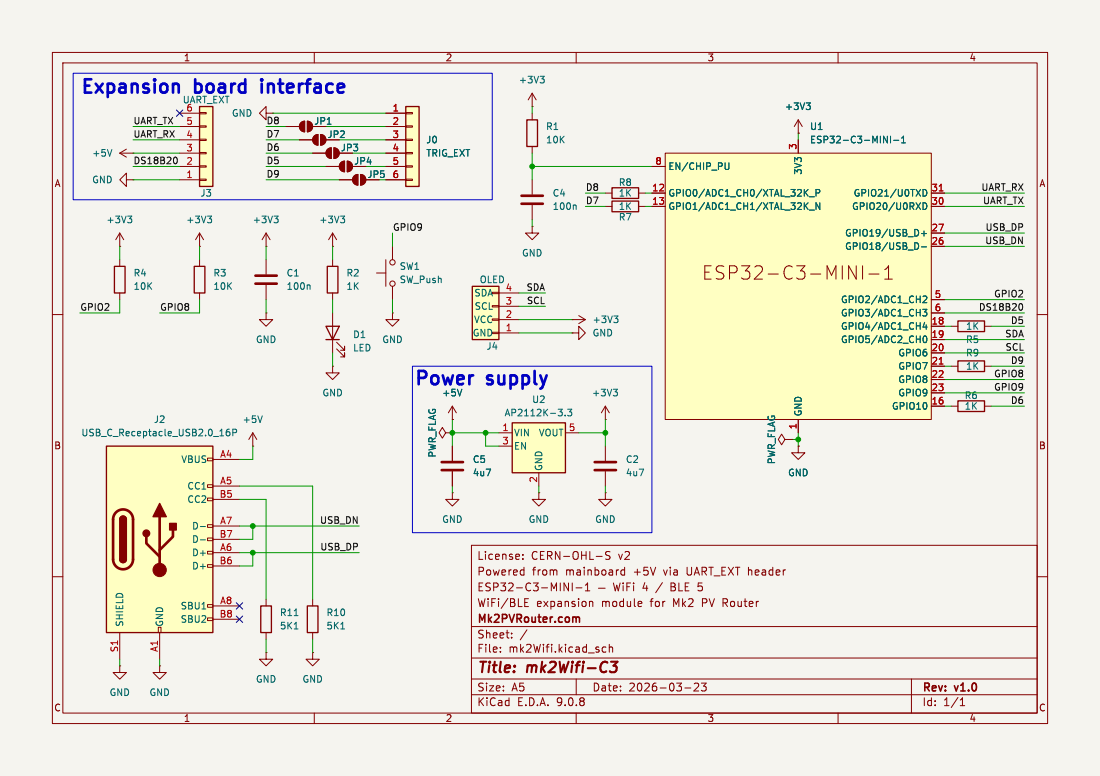
[picture p38: page 1]

2 VOUT 5 U2 AP2112K-3.3 GND GND ESP32-C3-MINI-1
