FredM67/PVRouter-KiCad/mainboard/3phaseDiverter.pdf

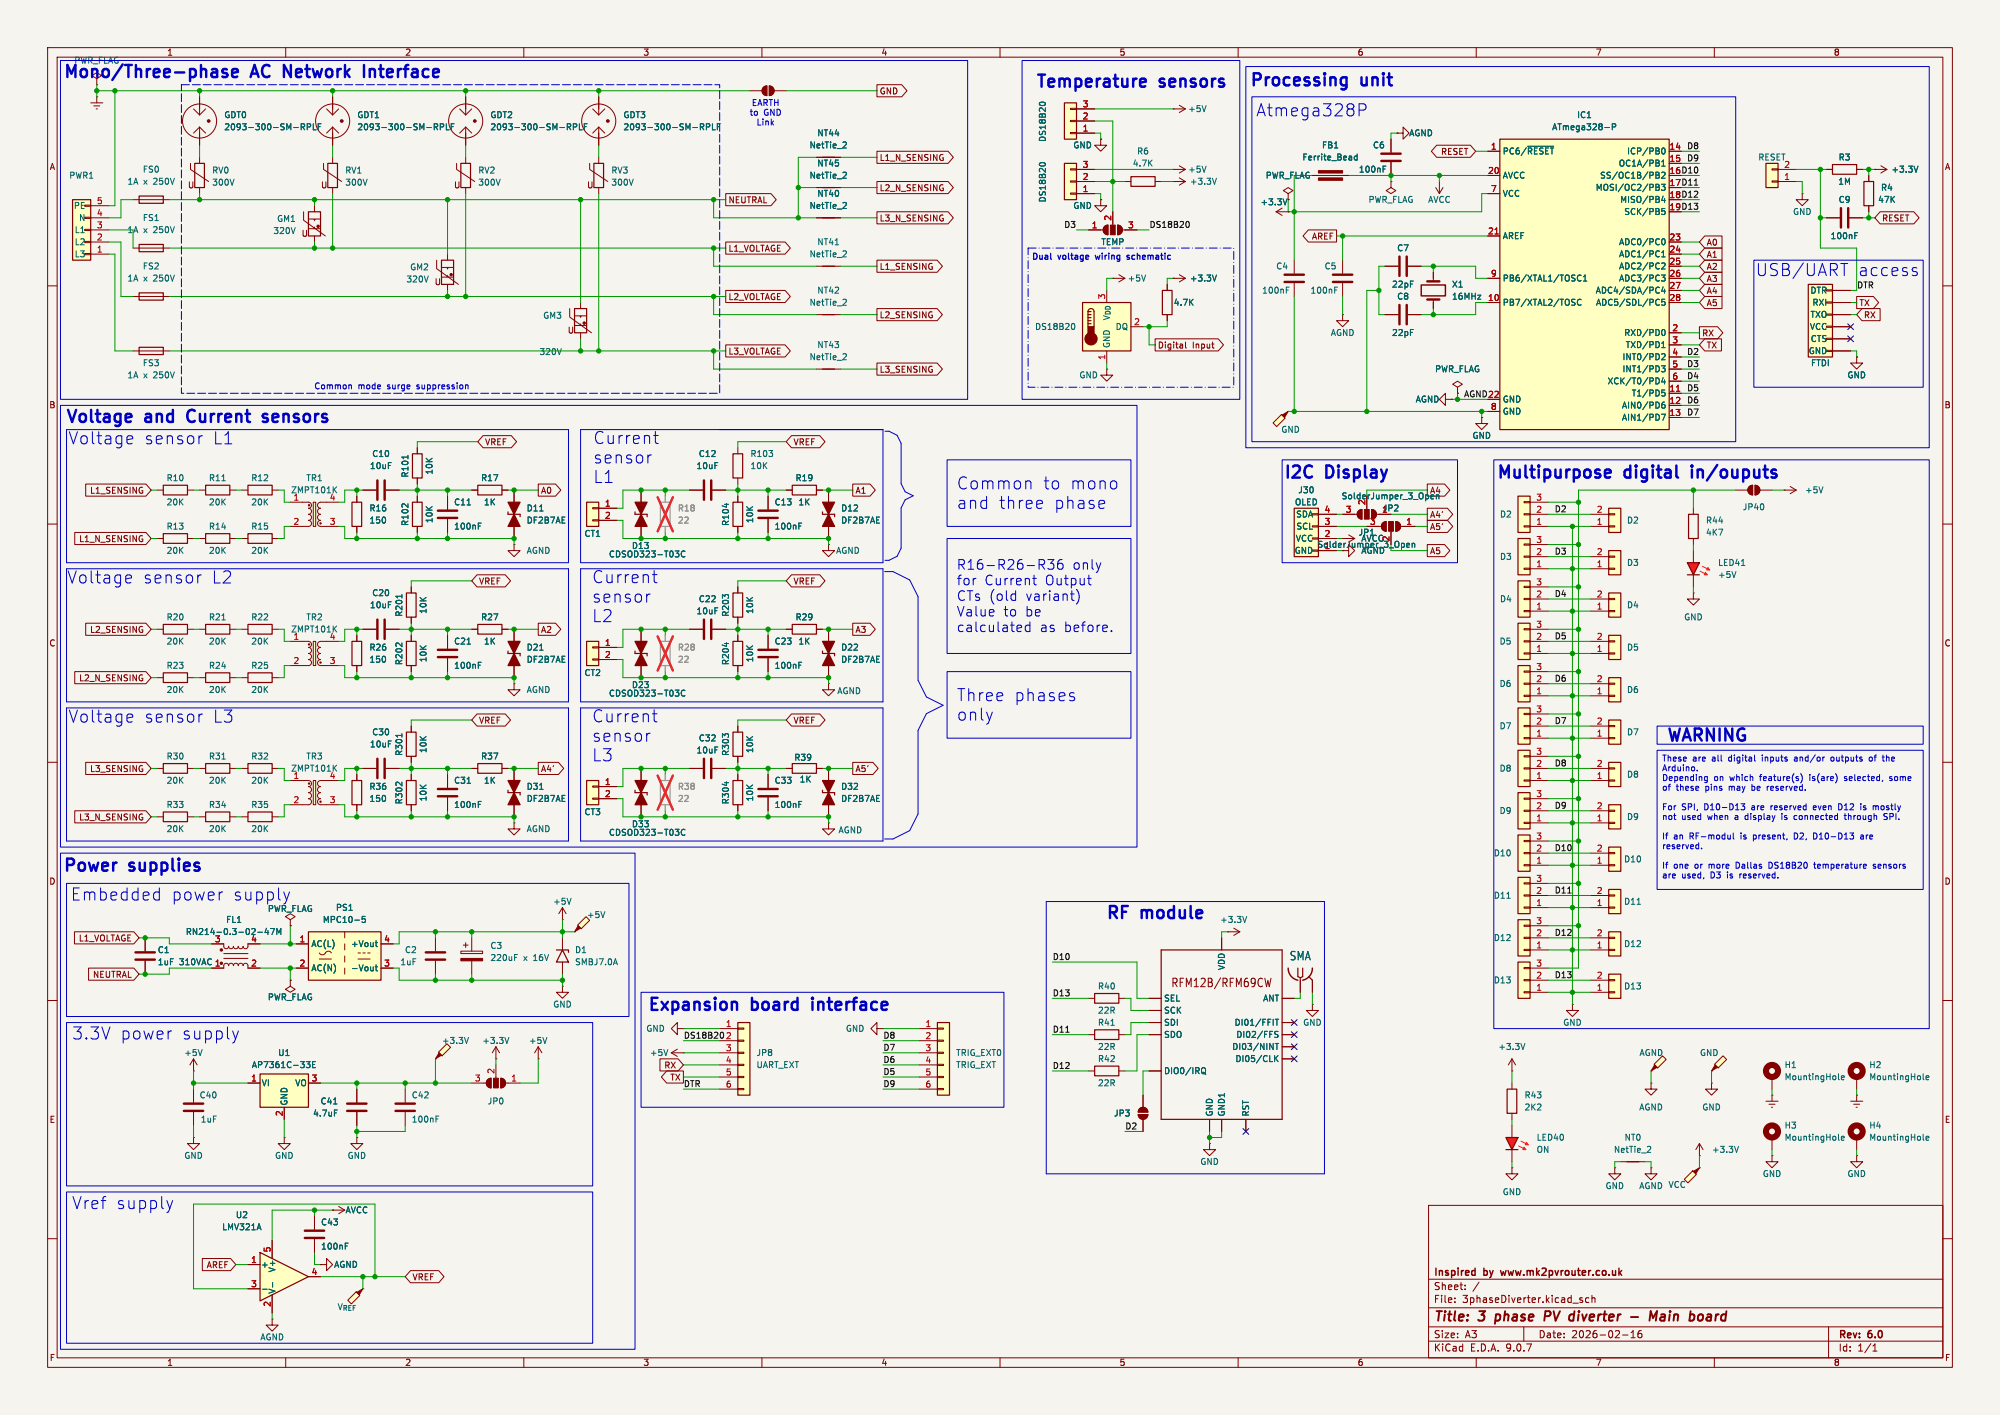
[picture p39: page 1]

Dual voltage wiring schematic EARTH
to GND

IC1 ATmega328-P
PC6/~{RESET} 1 AVCC 20 VCC 7 AREF 21 PB6/XTAL1/TOSC1 9 PB7/XTAL2/TOSC 10 GND 22 GND 8

Common mode surge suppression

Voltage and Current sensors
Voltage sensor L1

Multipurpose digital in/ouputs

File: 3phaseDiverter.kicad_sch Sheet: /
Id: 1/1 Title: 3 phase PV diverter - Main board
