FredM67/PVRouter-KiCad/expansion_boards/mk2Wifi-C3/mk2Wifi.pdf

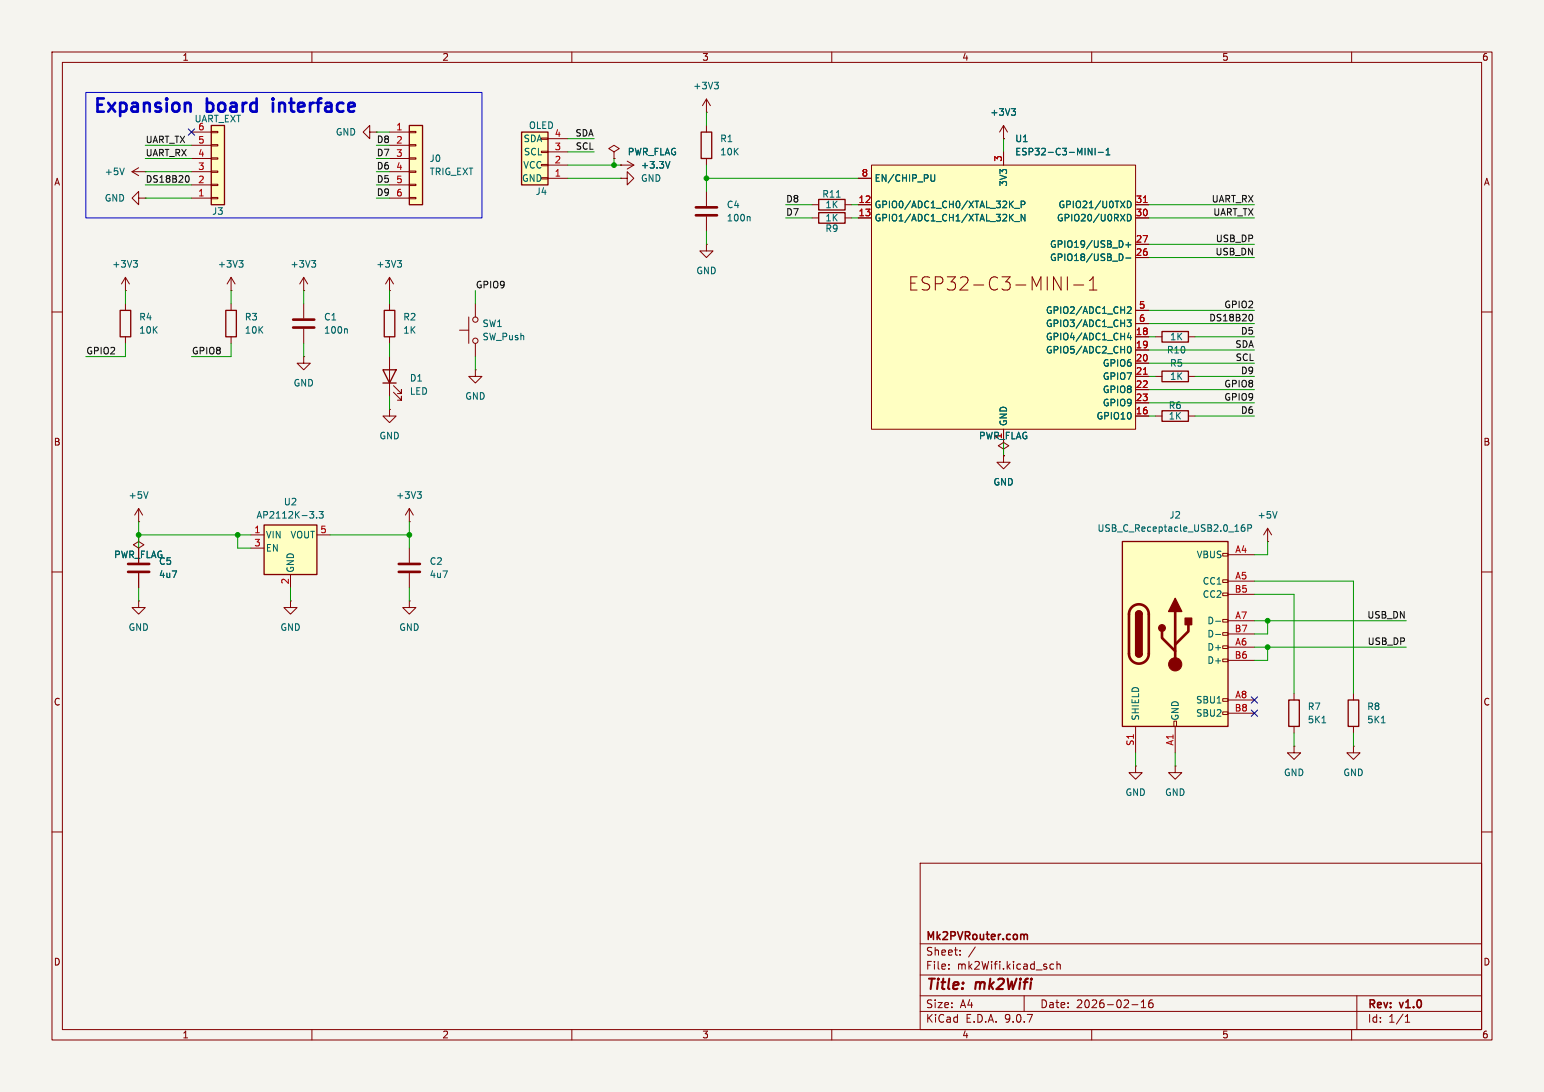
[picture p40: page 1]

1 GPIO21/U0TXD 31 GPIO20/U0RXD 30 GPIO19/USB_D+ 27 GPIO18/USB_D- 26 GPIO2/ADC1_CH2 5 GPIO3/ADC1_CH3 6 GPIO4/ADC1_CH4 18 GPIO5/ADC2_CH0 19 GPIO6 20 GPIO7 21 GPIO8 22 GPIO9 23 GPIO10 16 U1ESP32-C3-MINI-1 GND 1 VCC 2 SCL 3 SDA 4

Id: 1/1 Title: mk2Wifi File: mk2Wifi.kicad_sch Sheet: / Mk2PVRouter.com
