FredM67/PVRouter-KiCad/expansion_boards/mk2Wifi-C6/assets/mk2Wifi-C6-schematic.pdf

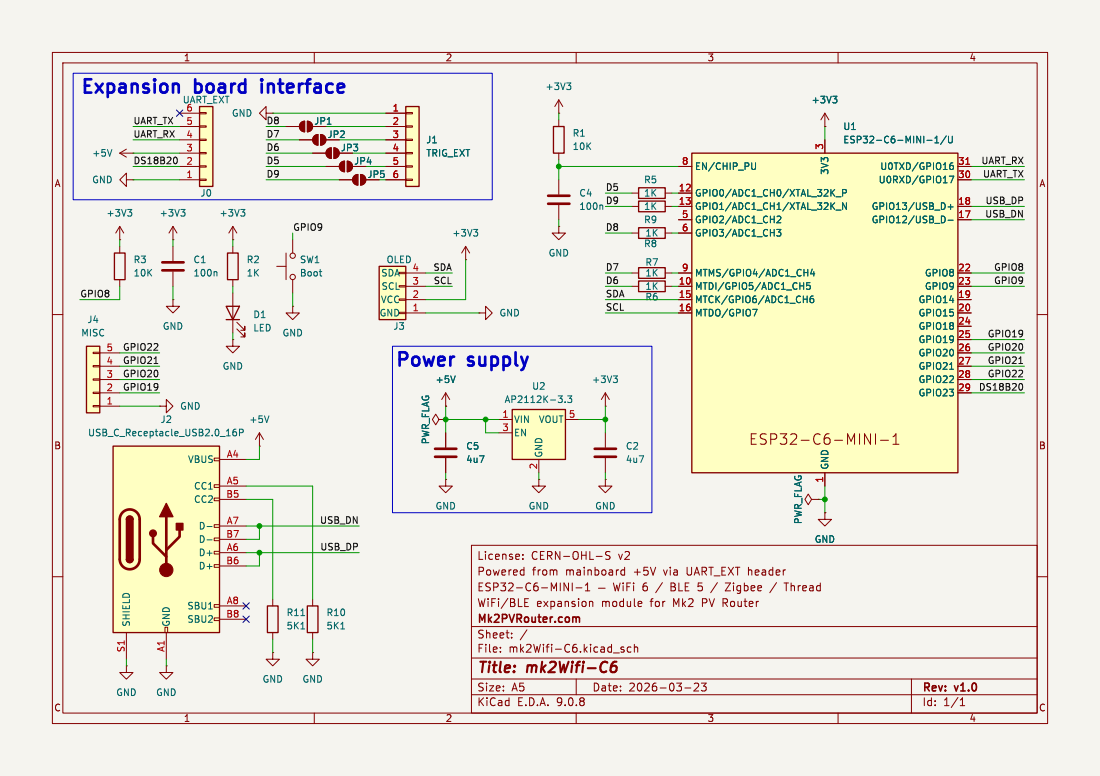
[picture p41: page 1]
