FredM67/PVRouter-KiCad/(commit log)

2022-04-27 A couple of changes
    [3phaseDiverter.kicad_pcb, 3phaseDiverter.kicad_sch]
2022-10-23 Enhanced version
    [3phaseDiverter-rounded-CuBottom.gbr, 3phaseDiverter-rounded-CuTop.gbr, 3phaseDiverter-rounded-EdgeCuts.gbr, 3phaseDiverter-rounded-MaskBottom.gbr, 3phaseDiverter-rounded-MaskTop.gbr, 3phaseDiverter-rounded-NPTH.drl, 3phaseDiverter-rounded-PTH.drl, 3phaseDiverter-rounded-PasteBottom.gbr]
2022-11-25 New PCB
    New PCB with separated ground around crystal, inductance for AVCC, dual optional power supply, Molex SL connectors
    [3phaseDiverter-rounded-CuBottom.gbr, 3phaseDiverter-rounded-CuTop.gbr, 3phaseDiverter-rounded-EdgeCuts.gbr, 3phaseDiverter-rounded-MaskBottom.gbr, 3phaseDiverter-rounded-MaskTop.gbr, 3phaseDiverter-rounded-NPTH.drl, 3phaseDiverter-rounded-PTH.drl, 3phaseDiverter-rounded-PasteBottom.gbr]
2022-11-25 Fix revision
    [3phaseDiverter-rounded.kicad_pcb, 3phaseDiverter.kicad_pcb, 3phaseDiverter.kicad_sch]
2023-03-17 Fix paths
    [3phaseDiverter-rounded.kicad_pcb, 3phaseDiverter.kicad_pcb]
2023-03-17 Add output schematic.. not finished
    [Output_stage.kicad_pcb, Output_stage.kicad_sch]
2023-03-19 Some tuning
    [Output_stage.kicad_pcb, Output_stage.kicad_sch]
2023-04-08 Tuning + labels
    [Output_stage.kicad_pcb]
2023-04-08 Fix MOC footprint
    [Output_stage.kicad_pcb]
2023-05-05 Create PCB
2023-07-04 Upt pcb
    [3phaseDiverter-rounded.kicad_pcb, 3phaseDiverter.kicad_pcb]
2023-07-07 Update some footprint
    [3phaseDiverter-rounded.kicad_pcb, 3phaseDiverter.kicad_pcb]
2023-07-07 Update some symbols/footprints
    [3phaseDiverter.kicad_sch, Output_stage.kicad_pcb, Output_stage.kicad_sch]
2023-08-06 PCB tuning
    [3phaseDiverter-rounded.kicad_pcb, 3phaseDiverter.kicad_pcb, 3phaseDiverter.kicad_sch]
2023-08-27 Update output
    [Output_stage.kicad_pcb]
2023-08-27 Update JLCPCB pckg
    [3phaseDiverter-rounded-CuBottom.gbr, 3phaseDiverter-rounded-CuTop.gbr, 3phaseDiverter-rounded-EdgeCuts.gbr, 3phaseDiverter-rounded-MaskBottom.gbr, 3phaseDiverter-rounded-MaskTop.gbr, 3phaseDiverter-rounded-NPTH.drl, 3phaseDiverter-rounded-PTH.drl, 3phaseDiverter-rounded-PasteBottom.gbr]
2023-08-27 Some updates
    [3phaseDiverter-rounded-CuBottom.gbr, 3phaseDiverter-rounded-CuTop.gbr, 3phaseDiverter-rounded-EdgeCuts.gbr, 3phaseDiverter-rounded-MaskBottom.gbr, 3phaseDiverter-rounded-MaskTop.gbr, 3phaseDiverter-rounded-NPTH.drl, 3phaseDiverter-rounded-PTH.drl, 3phaseDiverter-rounded-PasteBottom.gbr]
2023-09-11 Make LV track wider
    [Output_stage.kicad_pcb]
2023-09-11 Tiny tuning
    [Output_stage.kicad_pcb]
2023-09-16 Some update
    [Output_stage.kicad_pcb, Output_stage.kicad_sch]
2023-10-17 Fix wrong pad & tuning
    [3phaseDiverter-rounded.kicad_pcb, 3phaseDiverter.kicad_pcb]
2023-10-20 Fine tuning
    [3phaseDiverter-rounded.kicad_pcb]
2023-10-21 Tuning output stage
    [Output_stage.kicad_pcb]
2023-10-29 Upd PCB V4.0
    [3phaseDiverter-rounded.kicad_pcb, 3phaseDiverter.kicad_pcb, 3phaseDiverter.kicad_sch]
2023-10-29 Update output stage
    [Output_stage.kicad_pcb]
2023-11-25 Schema v4.4 mon 7SEG
    [RF.kicad_sch, mono.kicad_sch, untitled.kicad_sch]
2023-11-25 Led status RF
    [mono.kicad_sch]
2023-11-25 correction borne IC3 10
    [untitled.kicad_sch]
2023-11-25 single phase mainboard
    [1phaseDiverter.kicad_sch]
2023-11-25 Fix symbol pin
    [1phaseDiverter.kicad_sch, 3phaseDiverter.kicad_sch]
2023-11-26 modif Socle RF status / N°res
    [1phaseDiverter.kicad_sch]
2023-12-12 Schema LCD
    [1phaseDiverter.kicad_sch]
2023-12-12 supression archive
    [RF.kicad_sch, mono.kicad_sch, untitled.kicad_sch]
2024-05-03 New universal circuit
    [3phaseDiverter-rounded.kicad_pcb, 3phaseDiverter.kicad_pcb, 3phaseDiverter.kicad_sch]
2024-05-04 Additional protection
    [3phaseDiverter.kicad_pcb, 3phaseDiverter.kicad_sch]
2024-05-04 Some changes
    [3phaseDiverter.kicad_pcb, AP2112K-3.3TRG1.step, AP2112R5-3_3TRG1_DIO.step, FUS_MULTICOMP_MCMSF_MTC.step, LD05-23B05R2.step, LD10-23B05R2.step, RN114-x-02.stp, ZMPT101B.step]
2024-05-05 Minor changes
    [3phaseDiverter-rounded.kicad_pcb, 3phaseDiverter.kicad_pcb, 3phaseDiverter.kicad_sch]
2024-05-06 Add rounded tracks
    [3phaseDiverter-rounded.kicad_pcb]
2024-05-24 Add some symb and footprints
    [2093-xxx-sm.stp, GDT28H.STP]
2024-05-24 Surge, not finished
    [3phaseDiverter.kicad_pcb, 3phaseDiverter.kicad_sch]
2024-05-26 LM powered through AVCC
    [3phaseDiverter.kicad_pcb, 3phaseDiverter.kicad_sch]
2024-05-26 Split ground plane
    [3phaseDiverter.kicad_pcb, 3phaseDiverter.kicad_sch]
2024-05-30 Connect AGND with GND
    [3phaseDiverter.kicad_pcb]
2024-06-02 Enhance schematic design
    [3phaseDiverter.kicad_sch]
2025-03-03 Some SMD components
    [3phaseDiverter-rounded.kicad_pcb, 3phaseDiverter.kicad_pcb, 3phaseDiverter.kicad_sch]
2025-05-19 Add a lot of things !
    [3phaseDiverter-rounded.kicad_pcb, 3phaseDiverter.kicad_pcb, 3phaseDiverter.kicad_sch, ESP32.kicad_pcb, ESP32.kicad_sch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]
2025-07-06 Some tuning, fix footprint for PowerSupply
    [3phaseDiverter.kicad_pcb, 3phaseDiverter.kicad_sch]
2025-07-06 Update Expansion board
    [ESP32.kicad_pcb]
2025-07-06 Fix footprint for rfm module
    [3phaseDiverter.kicad_pcb]
2025-09-13 Add R42 and C43, update RFM12B/RFM69CW connections
    Added R42 (22R) and C43 (100nF) components to the PCB. Updated the RFM12B/RFM69CW module's SCK, SDI, and SDO connections to use new nets via R40, R41, and R42. Changed several resistor descriptions from 1/3W to 1/2W, adjusted silkscreen positions for some components, and made minor property and annotation updates throughout the board.
    [3phaseDiverter.kicad_pcb, 3phaseDiverter.kicad_sch]
2025-09-13 Remove rounded 3-phase diverter PCB files
    Deleted mainboard/3phaseDiverter-rounded.kicad_pcb, mainboard/3phaseDiverter-rounded.kicad_pro, and mainboard/3phaseDiverter.round-tracks-config. These files are no longer needed, possibly due to project cleanup or migration to a different board version.
    [3phaseDiverter-rounded.kicad_pcb]
2025-09-14 Add AP2112R5A-3.3TRG1 3D model and update KiCad files
    Added the AP2112R5A-3.3TRG1 STEP 3D model. Updated ESP32 and 3phaseDiverter KiCad project, schematic, PCB, and design rule files, including the addition of a new design rules file for the ESP32 board.
    [3phaseDiverter.kicad_pcb, 3phaseDiverter.kicad_sch, AP2112R5A-3.3TRG1.stp, ESP32.kicad_pcb, ESP32.kicad_sch]
2025-09-14 Replace GND resistor with solder jumper and update net
    Replaced the 0R resistor (R0) between Earth and GND with a solder jumper (GND_LINK1) for configurable connection. Updated net assignments from JP40-C to JP40-A, adjusted silkscreen text and PCB traces accordingly, and made minor corrections to component values and paths.
    [3phaseDiverter.kicad_pcb, 3phaseDiverter.kicad_sch]
2025-09-16 Update PCB properties and zones for mainboard
    Modified various custom properties (Monophasé, Triphasé, Option, Usine) in mainboard/3phaseDiverter.kicad_pcb to reflect new configuration and status. Updated zone definitions and net assignments, including teardrop and polygon zone details, to match revised electrical and mechanical design requirements.
    [3phaseDiverter.kicad_pcb, 3phaseDiverter.kicad_sch]
2025-10-17 Add AP2112R5A-3.3TRG1 3D model and update PCB
    Added the AP2112R5A-3.3TRG1.wrl 3D model to the KiCad 3dmodels directory. Updated the mainboard/3phaseDiverter.kicad_pcb and .kicad_pro files, likely to reference the new 3D model and reflect related layout or project changes.
    [3phaseDiverter.kicad_pcb]
2025-10-17 Update filled polygon definitions in PCB layout
    Refactored several filled polygon sections in 3phaseDiverter.kicad_pcb for improved clarity and consistency. Changes include more explicit point definitions, additional checks, and minor coordinate adjustments to enhance board rendering and maintainability.
    [3phaseDiverter.kicad_pcb]
2025-10-18 Update ESP32 board UART connector and net assignments
    Replaced JP1 pin header with pin socket, changed its position and orientation, and updated net assignments for UART pins. Adjusted net indices throughout the PCB to match schematic changes, updated silkscreen and fab layer properties, and modified JP3 socket position and labeling for consistency.
    [ESP32.kicad_pcb, ESP32.kicad_sch]
2026-01-03 Refactoring step 1/n
    [3phaseDiverter.kicad_pcb, 3phaseDiverter.kicad_sch, mk2Wifi.kicad_pcb, mk2Wifi.kicad_sch]
2026-01-04 Refactoring 2/n
    [3phaseDiverter.kicad_pcb, 3phaseDiverter.kicad_sch]
2026-01-05 Refactoring 3/n
    [3phaseDiverter.kicad_pcb, 3phaseDiverter.kicad_sch, MOV-14D471K.STEP]
2026-01-05 Refactoring 4/n
    [3phaseDiverter.kicad_pcb, 3phaseDiverter.kicad_sch]
2026-01-05 Tiny updates
    [3phaseDiverter.kicad_pcb, 3phaseDiverter.kicad_sch]
2026-02-10 Fix Gnd net class via diameter (0.5 -> 0.8mm)
    The Gnd net class had via_diameter=0.5mm with via_drill=0.6mm,
    resulting in a physically impossible negative annular ring.
    Changed via_diameter to 0.8mm to match other net classes.
2026-02-10 Fix voltage sensing resistor descriptions (R10-R35)
    Changed Description from "15K 1/2W 0.1% 25PPM/C 1206" to
    "20K 1/2W 0.1% 25PPM/C 0805" to match actual Value (20K)
    and footprint (0805) in both schematic and PCB files.
    [3phaseDiverter.kicad_pcb, 3phaseDiverter.kicad_sch]
2026-02-10 Add JLCPCB manufacturing and HV clearance design rules
    Populate the empty mainboard .kicad_dru with JLCPCB manufacturing
    rules (carried over from the expansion boards) and IPC-2221 based
    high-voltage clearance rules for safe mains routing on uncoated FR4:
    - HV/Surge to LV nets: 2.5 mm
    - HV to Surge: 1.5 mm
    - HV/Surge to board edge: 2.5 mm
2026-02-10 Implement TODO JLCPCB rules for NPTH annular ring and slot widths
    Replace the three TODO comments with actual DRC rules:
    - NPTH annular ring: 0.2mm min (pad must be 0.4mm larger than drill)
    - Plated slot minimum width: 0.5mm
    - Non-plated slot minimum width: 1.0mm
2026-02-10 Remove HV/Surge board edge clearance rules
    Too aggressive — flags every internal cutout at 2.5mm. The HV-to-LV
    and Surge-to-LV copper clearance rules already cover safety.
2026-02-10 Add HV Divider net class for voltage divider midpoint nets
    Create an intermediate "HV Divider" net class for the 12 resistor
    divider midpoint nets that bridge HV and LV domains through rated
    components. This allows a reduced 1.0mm clearance between HV and
    divider midpoints while keeping the full 2.5mm for all other HV-to-LV
    boundaries.
    Net class assignments:
    - 12 Net-(Rxx-Pad2) nets moved from Low Power/Power to HV Divider
    DRC clearance rules:
    - HV to HV Divider: 1.0mm
    - Surge to HV Divider: 2.5mm
    - HV Divider to LV: 2.5mm
2026-02-11 Update CLAUDE.md with net class details and project context
    Document all net classes with voltage domains, purposes, and clearance
    rules. Add notes about IPC-2221 basis, Thalassa enclosure, HV Divider
    intermediate class, and mark 3-phase/ as obsolete.
2026-02-12 Refactoring 5/n
    [3phaseDiverter.kicad_pcb, 3phaseDiverter.kicad_sch, ESP32.kicad_pcb, mk2Wifi.kicad_pcb]
2026-02-13 Refactoring 6/n
    [3phaseDiverter.kicad_pcb, 3phaseDiverter.kicad_sch]
2026-02-14 Fix ERC errors: replace power symbols with global labels for opamp-driven nets
    Resolved all ERC errors by:
    - Adding PWR_FLAG symbols for Earth, AC/L, AC/N, and +3.3V nets
    - Removing conflicting PWR_FLAG symbols on opamp output nets
    - Replacing AREF_B and VREF power symbols with global labels to avoid
    pin type conflicts (output + power_out) on opamp-driven reference nets
    - Converting remaining local AREF_B label to global label
    [3phaseDiverter.kicad_pcb, 3phaseDiverter.kicad_sch]
2026-02-14 Fix 3D models for Molex and fuse footprints
    - Update Molex footprint libraries and PCBs to use local .stp models
    instead of nonexistent .wrl or ${KICAD9_3DMODEL_DIR} references
    - Set correct offset/rotation for each Molex variant (2/3/4/6-pin)
    - Replace missing Littelfuse 395 fuse model with local Multicomp substitute
    [3phaseDiverter.kicad_pcb, Output_stage.kicad_pcb]
2026-02-14 Fix 3D model paths in expansion boards
    - Fix Molex and AP2112 relative paths to use ${KIPRJMOD} for correct resolution
    - Update deprecated ${KICAD6_3DMODEL_DIR} and ${KISYS3DMOD} to ${KICAD9_3DMODEL_DIR}
    [ESP32.kicad_pcb, mk2Wifi.kicad_pcb]
2026-02-14 Fix 3D model variable names in output stage board
    Update deprecated ${KICAD6_3DMODEL_DIR} and ${KICAD7_3DMODEL_DIR} to ${KICAD9_3DMODEL_DIR}
    [Output_stage.kicad_pcb]
2026-02-15 Refactor SPI_EXT header: rename to TRIG_EXT, remap pins for mk2Wifi
    Separate RFM module SPI from mk2Wifi signals to avoid bus contention.
    The header now provides ATmega328P input pins for home automation
    triggers from the mk2Wifi module. Move DS18B20 to UART_EXT header,
    remap pin labels (D10-D13 → D5-D9), and remove unused +3.3V pin.
    [3phaseDiverter.kicad_pcb, 3phaseDiverter.kicad_sch]
2026-02-15 Swap mk2Wifi to ESP32-C3-MINI-1 with USB-C and SPI protection
    Replace ESP32-WROOM-32 with ESP32-C3-MINI-1 (native USB, RISC-V).
    Add USB-C connector (J2) with 5.1K CC pull-down resistors (R7, R8).
    Add 1K series protection resistors on SPI outputs (R5/MOSI, R6/SCK,
    R9/SEL). Remove JP1 UART header. Switch passives to 0402/0603.
    Add local symbol and footprint libraries for ESP32-C3 and USB-C.
    [mk2Wifi.kicad_sch]
2026-02-15 Update mk2Wifi headers to match mainboard refactoring
    Rename SPI_EXT0 to TRIG_EXT0 with new pin labels (D5-D9) for home
    automation triggers. Swap pin 1/2 (GND/D8). Move DS18B20 from
    TRIG_EXT to UART_EXT pin 2. Update matching ESP32-side labels.
    [mk2Wifi.kicad_sch]
2026-02-15 Wire remaining ESP32-C3 GPIOs and fix mk2Wifi ERC errors
    Connect GPIO3 (DS18B20), GPIO5 (SDA), GPIO6 (SCL) directly and
    GPIO7 (D8) through R11 (1K) protection resistor. Fix duplicate
    power symbol references (#PWR01/03/04/08), add UserDef symbol
    library to sym-lib-table, and add PWR_FLAG symbols to +5V, +3.3V,
    and GND nets to resolve all ERC errors.
    [mk2Wifi.kicad_pcb, mk2Wifi.kicad_sch]
2026-02-15 Assign footprints and values to all mk2Wifi components
    Set resistor values (1K, 5K1, 10K) and 0402 footprints for R1-R11,
    capacitor values (100n, 4u7) with 0402/0603 footprints for C1-C5,
    and footprints for D1 (LED 0603), SW1 (CK PTS636S tactile), J0 and
    J3 (PinSocket 1x06). Values and footprints match emonWiFi reference
    design by circuit function.
    [mk2Wifi.kicad_sch]
2026-02-16 Finalize mk2Wifi PCB layout, project settings, and 3D model
    Update PCB layout with component placement and routing for all
    newly footprinted parts. Adjust zone clearance (0.25mm) and via
    sizes (0.8/0.4mm) in project settings. Add UserDef footprint
    library to fp-lib-table. Include ESP32-C3-MINI-1 STEP 3D model.
    [ESP32-C3-MINI-1-N4--3DModel-STEP-418109.STEP, mk2Wifi.kicad_pcb, mk2Wifi.kicad_sch]
2026-02-16 Add mk2Wifi documentation, board images, and PCB/schematic updates
    Add bilingual README (French default, English translation) with BOM,
    connector pinouts, GPIO mapping, power supply details, programming
    instructions, and USB-C safety warning. Include trimmed 3D render
    images (front, back, SMD, bare board) in assets/ folder.
    [mk2Wifi.kicad_pcb, mk2Wifi.kicad_sch]
2026-02-16 Add bilingual root README with project overview
    French default (Readme.md) and English translation (Readme.en.md)
    covering repository structure, mainboard features, expansion modules,
    output power stage, required tools, and links.
2026-02-16 Mark 1-phase and 3-phase as obsolete, remove ESP32 references
    Both legacy designs are still sold until the new universal mainboard
    is fully tested. ESP32 expansion module has been removed from the
    project.
2026-02-18 Add mainboard bilingual README with 3D renders and design documentation
    Add trimmed 3D render images (front, back, SMD, bare) to mainboard/assets/
    and create comprehensive bilingual documentation (FR/EN) covering board
    overview, full BOM, connector pinouts, ATmega328P pin mapping, power supply
    chain, resistor power dissipation calculations, surge protection, solder
    jumper configuration, expansion module integration, and programming.
    Includes current-output CT warning for burden resistor sizing.
    [3phaseDiverter.kicad_pcb, 3phaseDiverter.kicad_sch]
2026-02-18 Add bias divider simulation and fix README BOM accuracy
    - Add KiCad SPICE simulation circuit for VREF/2 bias divider
    (mainboard/simulation/)
    - Fix capacitor descriptions: C10/C20/C30 inline AC coupling
    (voltage), C12/C22/C32 inline AC coupling (current),
    C11/C13/C21/C23/C31/C33 are 100nF bypass caps (not 10uF)
    - Fix IC2 → U2 (LMV321A, not LM358)
    - Remove non-existent R9 and R99 (not on board)
    - Add missing C40 to BOM (1uF filtering cap on 5V rail)
    [3phaseDiverter.kicad_pcb, 3phaseDiverter.kicad_sch, bias_divider.kicad_sch]
2026-02-18 Update PCB layout and board render images
    [3phaseDiverter.kicad_pcb]
2026-02-20 Add Indicator KiCad project and PCB files
    Add a new KiCad project "Indicator" with PCB, schematic and project files plus panelized variants and a panel project. Files added: Indicator.kicad_pcb, Indicator.kicad_sch, Indicator.kicad_pro, Indicator_panelized.kicad_pcb, Indicator_panelized.kicad_dru, Indicator_panelized.kicad_pro, and panel.kicad_pro. The PCB includes footprints for an axial resistor, a 5mm THT LED and a 2-pin Molex connector, nets for the LED/resistor/connector, edge cuts and board outline, and basic fabrication/panelization settings.
    [Indicator.kicad_pcb, Indicator.kicad_sch, Indicator_panelized.kicad_pcb]
2026-02-27 Add LCSC part numbers, MPC10-5 footprint, and simulation updates
    - Add LCSC fields to mk2Wifi schematic (20 components for JLCPCB assembly)
    - Add LCSC fields to mainboard schematic (18x 20K resistors, 12x 100nF caps)
    - Add power indicator LED (LED40) and series resistor (R43) to mainboard
    - Add MPC10-5 AC-DC converter custom footprint and TMF_05105 3D model
    - Add CT and combined bias divider simulation schematics with generators
    - Update mainboard PCB layout and bias divider simulation
    [3phaseDiverter.kicad_pcb, 3phaseDiverter.kicad_sch, TMF_05105.stp, combined_bias_divider.kicad_sch, ct_bias_divider.kicad_sch, mk2Wifi.kicad_sch]
2026-02-27 Add LCSC part numbers for mainboard SMD components
    Assign LCSC fields to 37 additional mainboard components:
    - 12x 10K 0.1% thin film resistors (C95204, R101-R304)
    - 3x 22R, 2x 1K, 1x 4.7K, 1x 47K, 1x 1M resistors
    - 6x 10uF, 3x 1uF, 2x 22pF capacitors
    - LMV321 op-amp (C7972), SMBJ7.0A TVS (C224024)
    - 3x CDSOD323-T03C TVS diodes (C19170830)
    - Ferrite bead (C1002)
    Also update mk2Wifi schematic PDF export.
    [3phaseDiverter.kicad_sch]
2026-02-27 Add LCSC part number for DF2B7AE TVS diodes
    Assign LCSC C1973289 (Toshiba DF2B7AE,H3F) to D11, D12, D21, D22, D31, D32.
    [3phaseDiverter.kicad_sch]
2026-02-27 Replace U1 LDO regulator and increase output capacitor
    - U1: AP2112K-3.3TRG1 (SOT-23-5, 600mA) → AP7361C-33E (SOT-223, 1A, 340mV dropout)
    - C41: 1µF → 4.7µF per AP7361C datasheet (min 2.2µF output)
    - LCSC: U1=C500795 (Diodes Inc), C41=C19666 (Samsung Basic)
    [3phaseDiverter.kicad_pcb, 3phaseDiverter.kicad_sch]
2026-03-02 Add 5V power LED indicator and schematic rearrangement
    [3phaseDiverter.kicad_pcb, 3phaseDiverter.kicad_sch]
2026-03-02 Update PCB layout
    [3phaseDiverter.kicad_pcb]
2026-03-02 Add LCSC part numbers for remaining SMD components
    - R17, R19, R27, R29 (1K 0603): C21190 (YAGEO)
    - R16, R26, R36 (150Ω 0.1% thin film 0603): C425408 (UNI-ROYAL, 25ppm)
    - C3 (220µF 16V SMD electrolytic): C72496 (ROQANG)
    [3phaseDiverter.kicad_sch]
2026-03-02 Export mainboard schematic PDF
2026-03-02 Switch ADC bias resistors to Basic and update LCSC assignments
    - R101-R304 (10K): C95204 (0.1% thin film) → C25804 (1% Basic, sufficient for bias divider)
    - R16,R26,R36 (150Ω): C22808 (thick film) → C425408 (0.1% thin film)
    - Reduces extended unique parts from 9 to 8, saving $3 setup fee
    [3phaseDiverter.kicad_sch]
2026-03-02 Fix dangling labels in CT bias divider simulation
    Add stub wires from SIG/SIG_NF junctions to label positions
    so ERC passes cleanly (0 violations).
    [ct_bias_divider.kicad_sch]
2026-03-03 Tiny fixes
    [3phaseDiverter.kicad_pcb]
2026-03-04 Upgrade HV divider resistors from 0805 to 1206 with zone improvements
    Switch R10-R15, R20-R25, R30-R35 from C469660 (0805 20K 1/2W) to
    C706407 (1206 20K 1/4W 0.1% 25PPM/C) for better voltage margin.
    PCB changes:
    - Update all 18 resistor footprints to R_1206
    - Set all 24 HV divider zones to solid pad connection
    - Add thermal relief override on ZMPT TR1/TR2/TR3 pads 1 and 2
    - Replicate zone outlines from TR1 pad1 reference to all positions
    - Replicate via stitching pattern across all HV divider zones
    [3phaseDiverter.kicad_pcb, 3phaseDiverter.kicad_sch]
2026-03-04 Add RF module decoupling, fix power symbols, and assign LCSC parts
    Schematic:
    - Add FB2 ferrite bead + C44/C45 decoupling on RF1 VDD supply
    - Add R45 (47K) pull-up on RF1 SEL line
    - Fix #PWR030 symbol (was +3.3V, should be +5V)
    - Fix AGND symbols to use proper GNDA power symbol
    - Add PWR_FLAG on filtered +3.3V rail (ferrite bead breaks propagation)
    - Assign LCSC parts: FB2 (C1002), C44 (C19702), C45 (C14663)
    - Fix R45 LCSC from C23345 (22R) to C25819 (47K)
    PCB:
    - Update title block revision to 6.0
    Project:
    - Add Earth net class (1.3mm track, 1.45mm clearance)
    - Reassign Earth net from Surge to Earth class
    - Reorder net class priorities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
    [3phaseDiverter.kicad_pcb, 3phaseDiverter.kicad_sch]
2026-03-04 Rework HV clearance DRC rules for solder-mask-coated traces
    - Relax clearances from IPC-2221 B2 (uncoated) toward B3 (coated)
    since tracks are under solder mask: 325V peak 2.0→1.5mm,
    565V peak 2.5→2.0mm
    - Add inter-phase rules (L1↔L2↔L3) separate from phase-to-neutral
    - Add Earth net class rules (Earth↔HV, Earth↔LV)
    - Exclude pad-to-pad from all HV rules (manufacturer-rated spacing)
    - Add Earth net class to exclusion lists in cross-class rules
    [3phaseDiverter.kicad_pcb]
2026-03-04 Add ADC net class, fix Gnd track width, and add Library footprint path
    - Create ADC net class (0.5mm track) for analog sensing signals
    - Assign CT1/CT2/CT3 and ZMPT secondary nets to ADC class
    - Raise Gnd net class default track width from 0.2032mm to 0.5mm
    - Add Library.pretty to project fp-lib-table for HV warning symbols
    [3phaseDiverter.kicad_pcb]
2026-03-04 Widen +3.3V traces from 0.25mm to 0.5mm near LED area
    [3phaseDiverter.kicad_pcb]
2026-03-04 Update CLAUDE.md with current net classes and DRC clearance rules
    - Replace CT class with ADC, add Earth class
    - Add track widths to net class table
    - Document relaxed IPC-2221 clearances for solder-mask-coated FR4
    - Add clearance summary table with pad-to-pad exclusion note
    - Separate inter-phase (2.0mm) from phase-to-neutral (1.5mm)
2026-03-04 Fix stale component descriptions on 15 resistors
    - R101-R304 (12 CT bias resistors): "47K 1%" -> "10K 1%"
    - R18/R28/R38 (3 ZMPT primary resistors): "150 1/2W 0.1%" -> "22R"
    [3phaseDiverter.kicad_sch]
2026-03-04 PCB and schematic updates from review session
    [3phaseDiverter.kicad_pcb, 3phaseDiverter.kicad_sch]
2026-03-04 Fix DRC warnings: hybrid footprint attrs, RF1 text, GND thermal gap, Gnd track width
    - Set attr to 'through_hole smd' on hybrid footprints (R16/R26/R36, D13/D23/D33, RF1)
    in both PCB and UserDef library to resolve footprint_type_mismatch errors
    - Fix RF1 Reference/Value text thickness from 0.0889mm to 0.15mm (PCB + library)
    - Fix main GND zone thermal_gap from 0.23mm to 0.5mm to match other zones
    - Fix Gnd net class track_width from 0.2032mm to 0.5mm in project file
    [3phaseDiverter.kicad_pcb]
2026-03-05 Add mk2Wifi reserved silkscreen hatch, label solder jumpers, update footprints
    - Add hatched rectangle on F.SilkS around J5-J9/J19/J21-J24 connector block
    to indicate mk2Wifi reserved area
    - Change JP41 Value to "NSS" on F.SilkS (RF1 chip select)
    - Change JP3 Value to "IRQ" on B.SilkS (RF1 interrupt)
    - Update footprints from library
    [3phaseDiverter.kicad_pcb, 3phaseDiverter.kicad_sch]
2026-03-05 Enable D13/D23/D33 TVS diodes (remove DNP), update PCB and board renders
    [3phaseDiverter.kicad_pcb, 3phaseDiverter.kicad_sch]
2026-03-05 Add solder jumpers to mk2Wifi and custom smaller solder jumper footprint
    New UserDef footprint: SolderJumper-2_P1.0mm_Open_Pad0.8x1.2mm (compact
    1.0mm pitch, 0.8x1.2mm pads, 0.2mm gap for hand soldering).
    [mk2Wifi.kicad_pcb, mk2Wifi.kicad_sch]
2026-03-05 Fix split 3.3V power net on mk2Wifi OLED connector
    J4 (OLED) VCC pin was on +3.3V (net 13) while the rest of the board
    uses +3V3 (net 6), creating two separate unconnected power nets.
    Changed #PWR6 to +3V3 in schematic and reassigned J4 pad 2 in PCB.
    [mk2Wifi.kicad_pcb, mk2Wifi.kicad_sch]
2026-03-05 Fix DRC edge clearance violations and minor schematic cleanup
    [mk2Wifi.kicad_pcb, mk2Wifi.kicad_sch]
2026-03-05 Update mk2Wifi PCB layout and board renders
    [mk2Wifi.kicad_pcb]
2026-03-05 Update mainboard PCB layout and project defaults
    [3phaseDiverter.kicad_pcb]
2026-03-05 Fix silk labels
    [3phaseDiverter.kicad_pcb]
2026-03-05 Fix component descriptions and add datasheet links
    - PS1 (MPC10-5): fix description and datasheet URL (was TMF05105)
    - D13/D23/D33 (CDSOD323-T03C): fix description (was resistor text)
    - D11/D12/D21/D22/D31/D32 (DF2B7AE): fix description (wrong package)
    - GDT0-GDT3: add Bourns 2093 datasheet link
    - RV0-RV3: add MOV14D varistor datasheet link
    - GM1-GM3: add IsoMOV datasheet link
    [3phaseDiverter.kicad_pcb, 3phaseDiverter.kicad_sch]
2026-03-18 Split mk2Wifi into C3 and C6 variants
    Rename mk2Wifi to mk2Wifi-C3 (ESP32-C3-MINI-1, current design).
    Create mk2Wifi-C6 as a copy, ready for ESP32-C6-MINI-1 migration.
    Updated project names, title blocks, and internal references.
    [mk2Wifi-C6.kicad_pcb, mk2Wifi-C6.kicad_sch, mk2Wifi.kicad_pcb, mk2Wifi.kicad_sch]
2026-03-19 Migrate mk2Wifi-C6 schematic to ESP32-C6-MINI-1
    - Replace ESP32-C3-MINI-1 with ESP32-C6-MINI-1 (PCM_Espressif symbol)
    - Reassign LED GPIOs to left-side pins: D5→IO4, D6→IO5, D7→IO3, D8→IO0, D9→IO1
    - Move DS18B20 to right-side IO23 for direct routing to J3
    - USB on IO12/IO13, I2C on IO6/IO7, UART unchanged
    - Remove local PCM_Espressif footprint library (use global)
    - Remove C3 footprint file from C6 project
    [mk2Wifi-C6.kicad_sch]
2026-03-20 Update mk2Wifi-C6 PCB layout, routing, and LCSC refs
    - Complete PCB routing for ESP32-C6-MINI-1 board
    - Add GND copper pours on F.Cu and B.Cu with 51 stitching vias
    - Add +5V pour on F.Cu
    - Add USB diff pair, I2C, UART, GPIO signal routing
    - Add LCSC part number C5736265 for U1 (ESP32-C6-MINI-1-N4)
    - Update project settings (USB net class, track widths)
    [mk2Wifi-C6.kicad_pcb, mk2Wifi-C6.kicad_sch]
2026-03-21 Rename mk2Wifi-C6 asset images and adjust silkscreen text
    - Remove old mk2Wifi-*.png assets (C3 naming)
    - Add renamed mk2Wifi-C6-*.png board render images
    - Move "mk2WiFi v1.0" silkscreen text on B.SilkS
    [mk2Wifi-C6.kicad_pcb]
2026-03-21 Update READMEs for ESP32-C6 migration
    - Rewrite mk2Wifi-C6 READMEs for ESP32-C6-MINI-1 (WiFi 6, Zigbee, Thread)
    - Update GPIO mapping, BOM, and design file references for C6
    - Update main READMEs to list both mk2Wifi-C3 and mk2Wifi-C6 variants
2026-03-23 Add schematic descriptions and SVG exports to mk2Wifi READMEs
    - Add title block comments (description, MCU, power, license) to both C3 and C6 schematics
    - Rename C3 schematic title from "mk2Wifi" to "mk2Wifi-C3"
    - Export schematic SVGs and add Schematic sections to all four READMEs
    [mk2Wifi-C6.kicad_sch, mk2Wifi.kicad_sch]
2026-03-23 Add schematic PDFs and make SVG images clickable links
    Clicking the schematic image in any README now opens the PDF version.
2026-03-23 Add schematic description and exports to mainboard READMEs
    - Add title block comments (description, key components, license) to mainboard schematic
    - Update company field to Mk2PVRouter.com
    - Export schematic as SVG and PDF, add clickable schematic section to both READMEs
    [3phaseDiverter.kicad_sch]
2026-03-23 Update mainboard schematic and re-export SVG/PDF
    [3phaseDiverter.kicad_sch]
2026-03-23 Add output_stage schematic description, SVG/PDF exports, and READMEs
    - Add title block comments to output_stage schematic
    - Export schematic as SVG and PDF
    - Write full bilingual READMEs (FR/EN) with BOM, design notes, and clickable schematic
    [Output_stage.kicad_sch]
2026-03-23 Update output_stage to MOC3043M and re-export schematic
    - Migrate opto-triac from MOC3041M to MOC3043M (lower trigger current, Ift=5mA)
    - Update READMEs and title block comment
    - Re-export SVG and PDF
    [Output_stage.kicad_sch]
2026-03-23 Update output_stage: R1=220, MOC3063M notes, board images
    - Change R1 from 120 to 220 ohm (sized for MOC3043M IFT=5mA, IF~10mA at 3.3V)
    - Update schematic notes: 390 ohm for 5V, MOC3063M as 600V alternative
    - Add board images (front, back, bare) to READMEs
    - Re-export schematic SVG/PDF
    [Output_stage.kicad_sch]
2026-03-23 Fix output_stage READMEs: any available pin, not just D5-D9
    Pin availability depends on configuration (RF module, mk2Wifi, OLED, etc.).
2026-03-23 Add gitignore entries for DRC/BOM/simulation temp files
    Also includes output_stage project files updated by KiCad 9.
    [Output_stage.kicad_pcb]
2026-03-24 Fix power supply reference: RAC05E-05SKT → MPC10-5 (Multicomp Pro, 10W)
    The mainboard uses a Multicomp Pro MPC10-5 (10W, 5V/2A), not a
    Mornsun RAC05E-05SKT (3W). Updated both READMEs and re-added
    schematic title block comments with corrected reference.
    [3phaseDiverter.kicad_sch]
2026-03-24 Set allow_missing_courtyard on all Unspecified-type footprints
    Adds the allow_missing_courtyard attribute to 46 footprints with
    Unspecified type (kibuzzard labels, HV symbols, test points, mounting
    holes, solder jumpers, logos, net ties). Clears the footprint_type_mismatch
    DRC error — board now has 0 DRC errors.
    [3phaseDiverter.kicad_pcb]
2026-03-24 Revert allow_missing_courtyard on solder jumpers (they have courtyards)
    [3phaseDiverter.kicad_pcb]
2026-03-24 Sync library footprints with board: fix attrs and courtyard flags
    - Add allow_missing_courtyard to library copies: Alsace, SolderWire,
    HV symbols (small + big), RFM12B_RFM69CW
    - Add board_only to HV symbol libraries (matching board)
    - Remove smd from R_PTH_SMD and SOD-323 combo libraries (board uses
    through_hole only — adding smd causes DRC footprint_type_mismatch)
    - Restore smd + allow_missing_courtyard on RFM69CW board copy
    Reduces DRC errors from 8 to 1 (remaining: inherent dual SMD/THT
    mismatch on RF1). Eliminates 28 lib_footprint_mismatch warnings
    for local libraries.
    [3phaseDiverter.kicad_pcb]
2026-03-24 Update mainboard: fix footprint attrs, add ground stitching vias, re-add title block
    - Sync board footprints from library (clears 11 lib_footprint_mismatch warnings)
    - Add ground stitching vias (GND + GNDA) for improved ground planes
    - Re-add schematic title block comments with corrected MPC10-5 reference
    - Fix RFM69CW board attr: restore smd + add allow_missing_courtyard
    DRC: 2 errors (RF1 inherent dual-type + missing courtyard),
    34 warnings (all silkscreen cosmetic).
    [3phaseDiverter.kicad_pcb, 3phaseDiverter.kicad_sch]
2026-03-24 Add key components section to CLAUDE.md
    Lists the main ICs, power supply (MPC10-5), LDO, radio module,
    and sensing components for quick reference.
2026-03-24 Add mainboard PCB layout summary to CLAUDE.md
    Documents the four board zones (connectors, LV logic, analog sensing,
    HV power), key layout characteristics including decoupling distances,
    ground stitching density, and analog channel routing spans.
2026-03-25 Fix Alsace logo footprint mismatch in mk2Wifi-C6 board
    Add allow_missing_courtyard attr to match library copy, eliminating
    the lib_footprint_mismatch DRC warning.
    [mk2Wifi-C6.kicad_pcb]
2026-03-25 Add mk2Wifi-C6 board info to CLAUDE.md
2026-03-25 Fix HV symbol and logo footprint attrs in output_stage board
    Add allow_missing_courtyard to 2 HV symbols and 2 kibuzzard logos,
    eliminating 2 lib_footprint_mismatch DRC warnings. DRC: 0 errors,
    12 warnings (3 lib mismatch from KiCad version, 7 silk edge, 2 mirrored text).
    [Output_stage.kicad_pcb]
2026-03-25 Add output stage board info to CLAUDE.md
2026-03-25 Add copper strap detail to output stage description
2026-03-25 Add 3D copper strap models to output stage board
    Two 1.5mm² copper straps (LINE and S/LINE) connecting J1 Phoenix
    connector to Q1 triac via REF test pads. Straps traverse the PCB
    twice through drill holes. Generated with cadquery (generate_straps.py).
    [CopperStrap_LINE.step, CopperStrap_SLINE.step, Output_stage.kicad_pcb]
2026-03-25 Rework copper strap footprints with real THT pads
    Replace 4 standalone REF test pads with 2 proper CopperStrap footprints
    (W1/W2) having real THT pads (3mm, 1.5mm drill) on LINE/S_LINE nets.
    Footprints include Fab layer artwork showing strap path and 3D STEP
    models. Add UserDef library to output_stage fp-lib-table.
    [CopperStrap_LINE.step, CopperStrap_SLINE.step, Output_stage.kicad_pcb]
2026-03-30 Add MISC GPIO connector and update mk2Wifi-C6 docs
    Add 5-pin MISC header (GPIO19-22) for additional user I/O.
    Update readmes with complete strapping pin documentation (all 5 pins),
    corrected UART GPIO mapping (GPIO16/GPIO17), new connector pinouts,
    and regenerated schematic PDF/SVG. Rename UART_EXT connector to J0.
    [mk2Wifi-C6.kicad_pcb, mk2Wifi-C6.kicad_sch]
2026-03-30 Update CLAUDE.md mk2Wifi-C6 section
    Add MISC connector (J4), strapping pins, UART mapping, corrected
    connector references (J0-J4), and SW1 boot mode button.
2026-04-05 Fix dual footprint
    [3phaseDiverter.kicad_pcb]
