FredM67/PVRouter-KiCad/(notices)

Notices in the files:
output_stage/Output_stage.kicad_sch:
License: CERN-OHL-S v2
parts and their libraries:
Copyright 2021 Accelerated Designs. All rights reserved.
